WenWeiCheng/S16011-CCD/README.md

## FPGA 硬件平台

### CCD 模块

只管 CCD 的移位时序产生、数据缓存、数据发送，曝光时间由其它控制（比如计时器）。

时序逻辑：接收一个曝光结束信息，然后开始对像素进行移位读出。同时控制 ADC 对读出的模拟信号进行采样，解析输出数据，去掉bevel像素，保留暗像素和感光像素信号，数据存在 ram 中。

输入接口：

- 复位：同时清除缓存帧

- 曝光信号：下降沿开始电荷读出、模数转换、数据解析和缓存
- 图像高度 (16bit)：
- 图像宽度 (16bit)：
- 斜边像素 (16bit)：上下左右的数量
- 空白像素 (4bit)：左右数目
- 读出模式 (2bit)：area scan, line binning
- 垂直合并 (16bit)：垂直合并行数
- vertical-binning-offset (16bit)：垂直合并偏移
- 读出帧：下降沿启动一帧数据的读出

输出接口：

- USB 控制器 FIFO 接口
- 缓存帧数目
- CCD读出状态：空闲/忙
- 缓存读出状态：空闲/忙

存储帧长度、帧数等信息。接收帧发送指令，将一帧数据通过 FIFO 接口把数据发给 USB 控制器的 FIFO

### FPGA 框图

集成 CCD 模块、SPI 控制器、IIC 控制器、GPIO 模块、串口、计时器、MicroBlaze 软核。

## FPGA 软件

### 总线驱动
- GPIO 驱动：触发，启停信号

- SPI 驱动：ADC, DAC 寄存器配置和简单数据读取

- IIC 驱动：命令收发

- UART 驱动：调试

- Timer 驱动

通过uart、ila调试。
UART 驱动：回环，直接在主机上看结果
命令解析结果回显，mock 数据发送

总线驱动调试：uart触发调试，必要时用 ila 抓波形
SPI 驱动：uart触发，用 ILA 抓取波形
GPIO 驱动：uart触发，用 LED 输出状态
IIC 驱动：uart触发，用 ILA 抓取波形

### 设备驱动

都有 mock 模式，返回 mock 数据
TEC 驱动：启停，电压电流监控，功率设置
CCD 驱动：adc配置，曝光时间控制，开始/结束控制，读取ccd状态（曝光/读出/空闲），读取数据缓存状态，读取数据缓存，清空数据缓存，设置触发

设备驱动调试：设备模式，需要连接驱动板，真实数据回传，必要时配合ila查看实际波形
TEC 驱动：启停、电流、电压监控、功率设置
CCD 驱动：ADC 配置+数据读取和串口发送，主机用 python 接收和显示

### 主控

实现主机的命令解析和执行，命令可以来自iic，也可以来自 uart。发送数据可以通过USB，也可以通过uart。

uart 主控调试：无设备模式，不需要连接驱动板

## USB 控制器软件

命令、数据转发

## 主机的相机驱动和API封装

命令发送
数据获取

1. 测试下位机的命令循环
2. 底层驱动调试：设置一个 mock 模式，调用接口、收到伪数据
3. API 封装调试：在上位机中直接操作
