WenWeiCheng/S16011-CCD/00-docs/verilog-design/.assets/ccd-state-machine.png

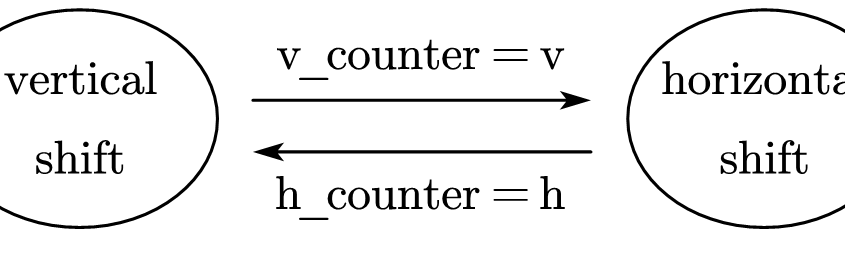
00-docs/verilog-design/.assets/ccd-state-machine.png
