WenWeiCheng/S16011-CCD/00-docs/verilog-design/.assets/ccd-write-fifo-sm.png

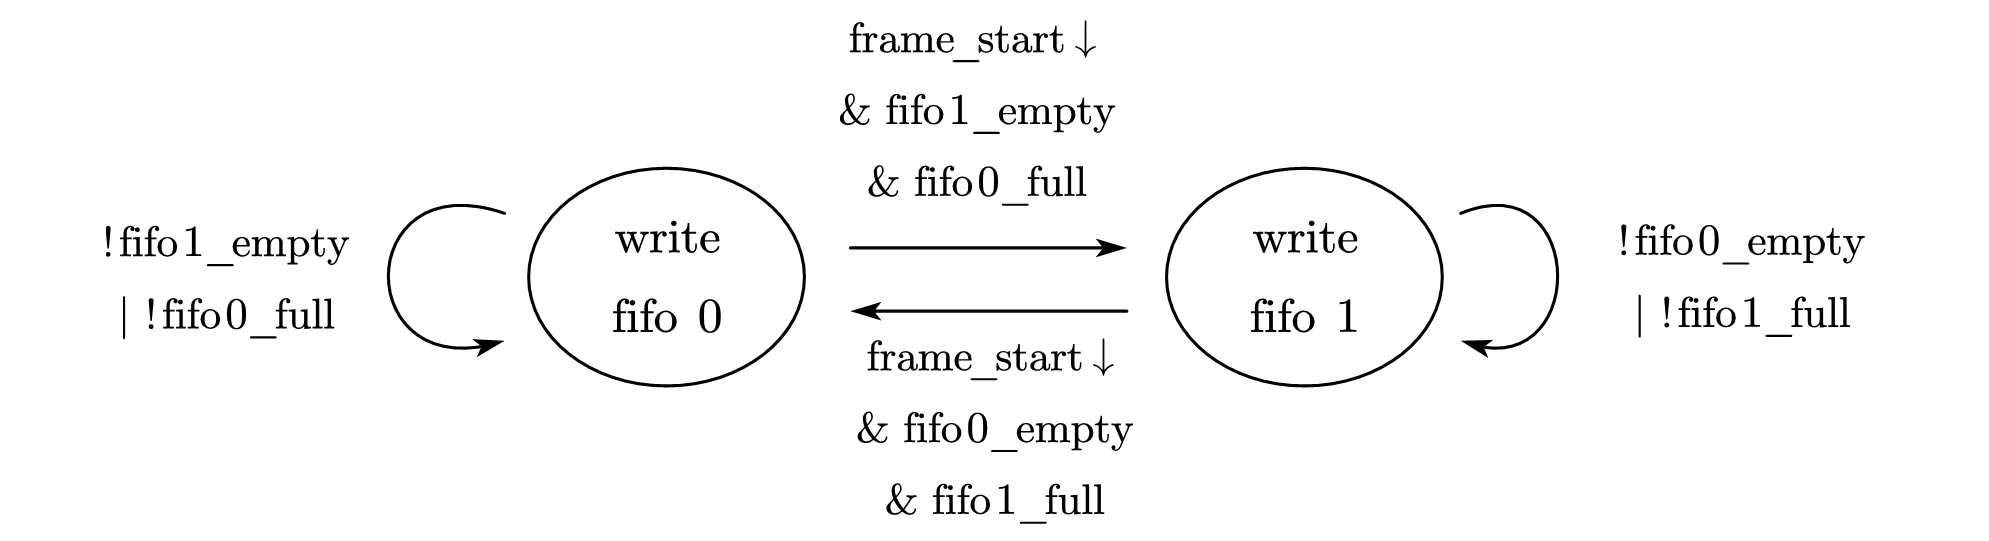
00-docs/verilog-design/.assets/ccd-write-fifo-sm.png
