WenWeiCheng/S16011-CCD/00-docs/verilog-design/statemachine/ccd-frame-buf-ddr-arch.png

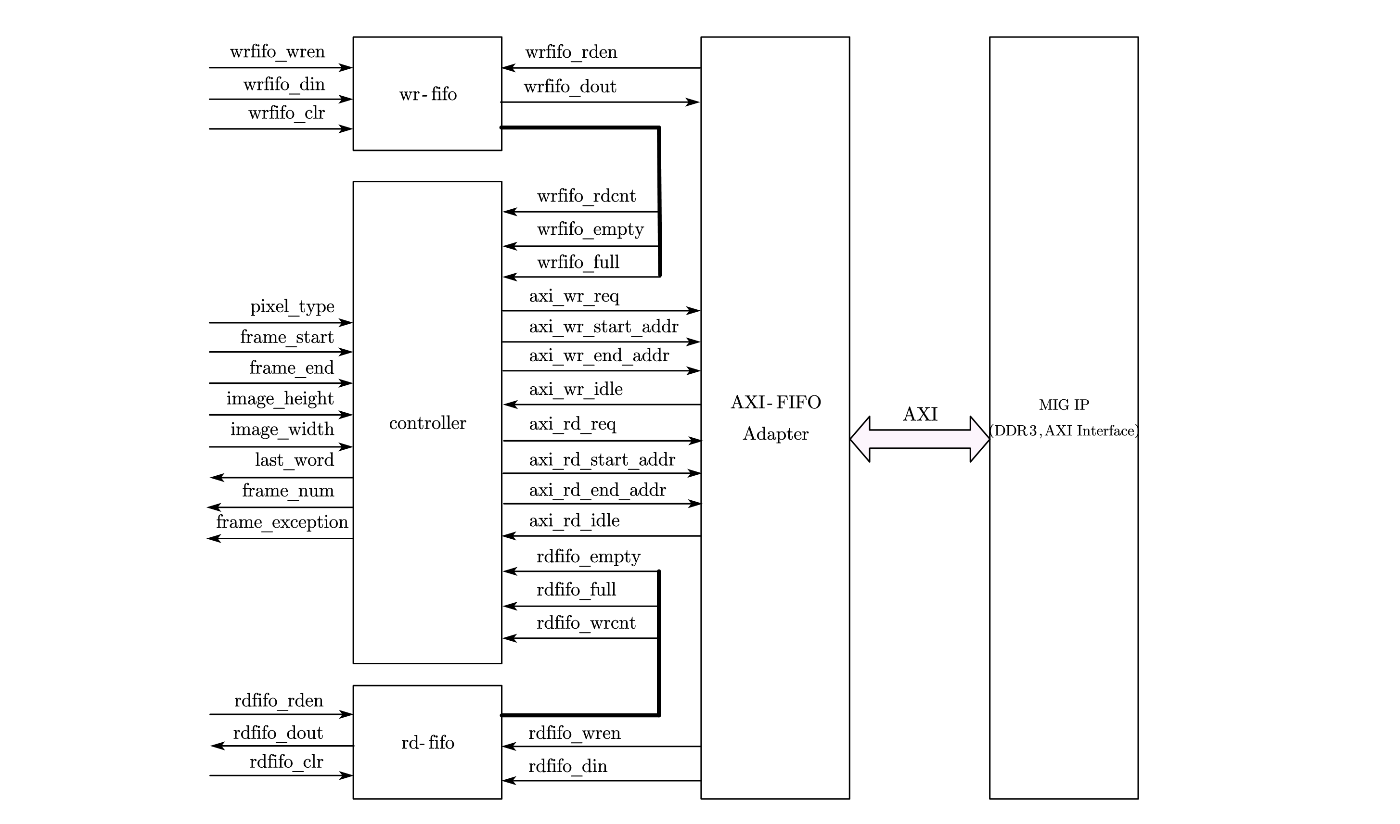
00-docs/verilog-design/statemachine/ccd-frame-buf-ddr-arch.png
