WenWeiCheng/S16011-CCD/00-docs/verilog-design/statemachine/ccd-memory-sm.png

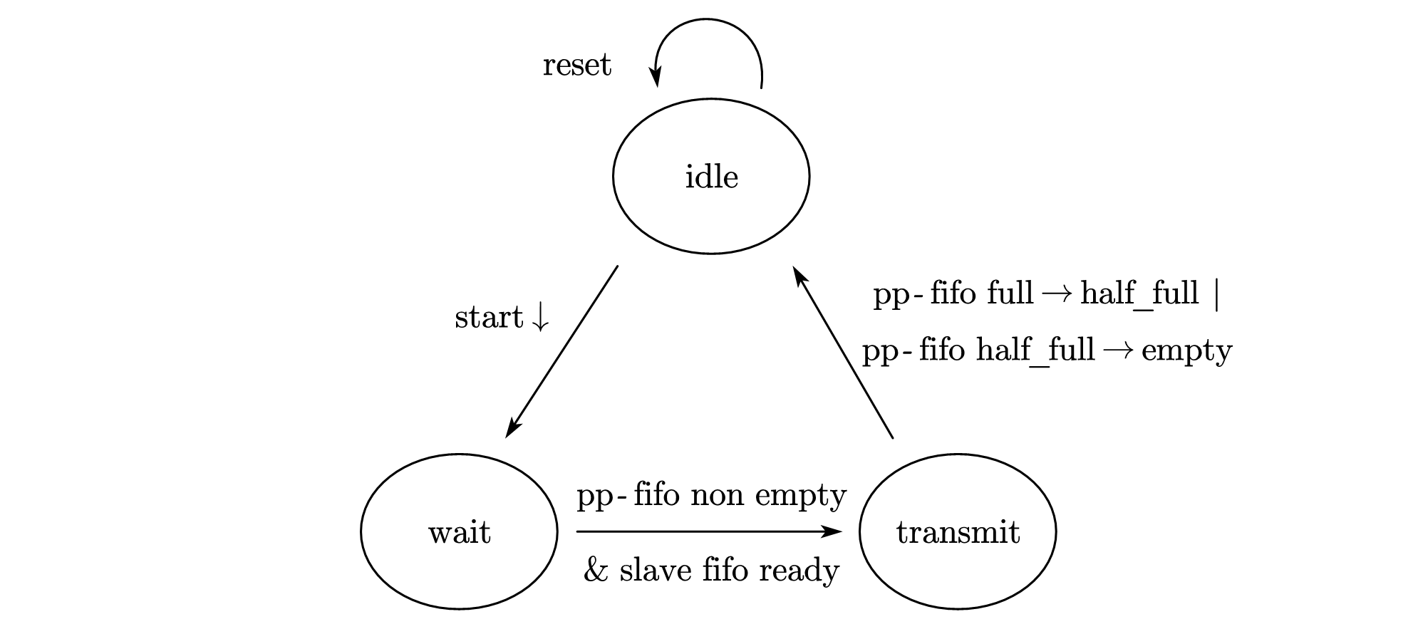
00-docs/verilog-design/statemachine/ccd-memory-sm.png
