WenWeiCheng/S16011-CCD/01-pcb/BOM.xlsx

Sheet: Driver
型号 | 类型 | 描述 | 零售单价 |  |  |  |  | 销售状态
 |  |  | DigiKey | Mouser | 立创商城 | 淘宝 | 最低价
AD4088 | ADC | 14-Bit, 10 MSPS, Low Noise, Low Power SAR ADC | ¥268.00 |  |  |  | ¥268.00 | New

Sheet: Controller
型号 | 类型 | 描述 | 零售单价 |  |  |  |  | 销售状态
 |  |  | DigiKey | Mouser | 立创商城 | 淘宝 | 最低价
CY7C68013A-56PVXC | USB 收发器 | EZ-USB® FX2LP TM USB 微控制器高速 USB 外设控制器 |  |  | ¥107.74 | ¥20.00 | ¥20.00 | EOL
