WenWeiCheng/S16011-CCD/01-pcb/old-driver/CCD驱动板电路原理图2025_03_28_dac8311_ads1118.pdf

# FPC1HC⁻FPC⁻⁰³⁻⁰⁹⁻³¹RLTAG

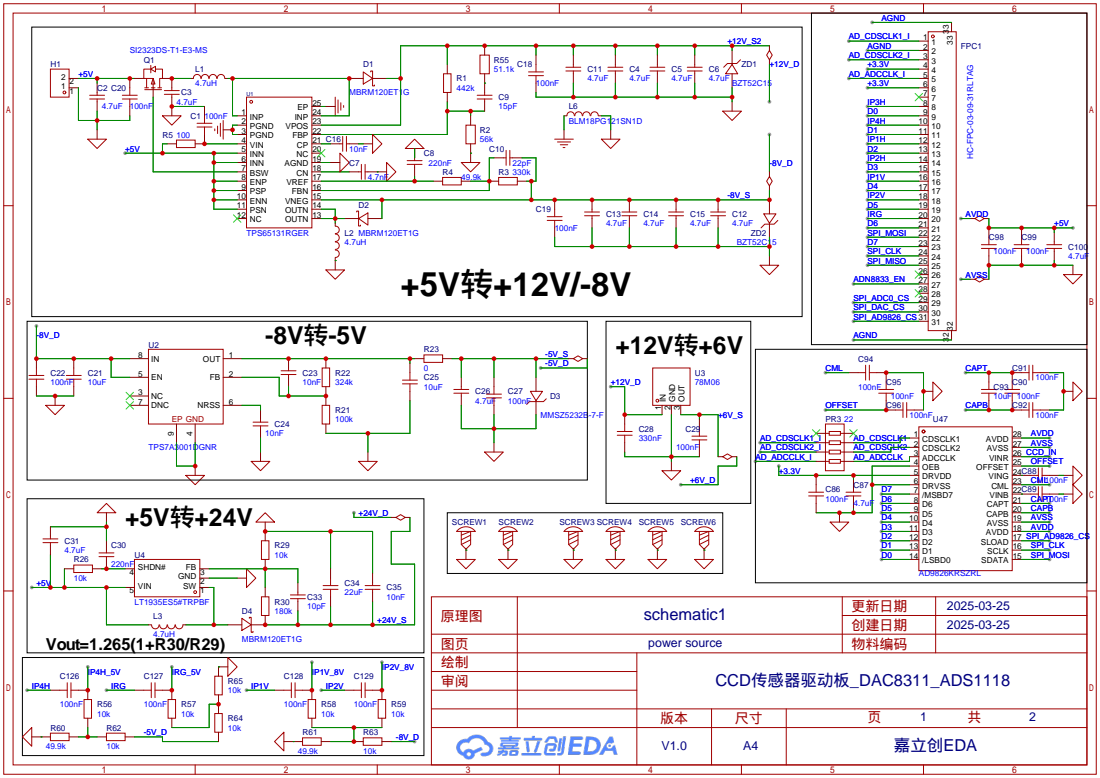
[picture p20: page 1]

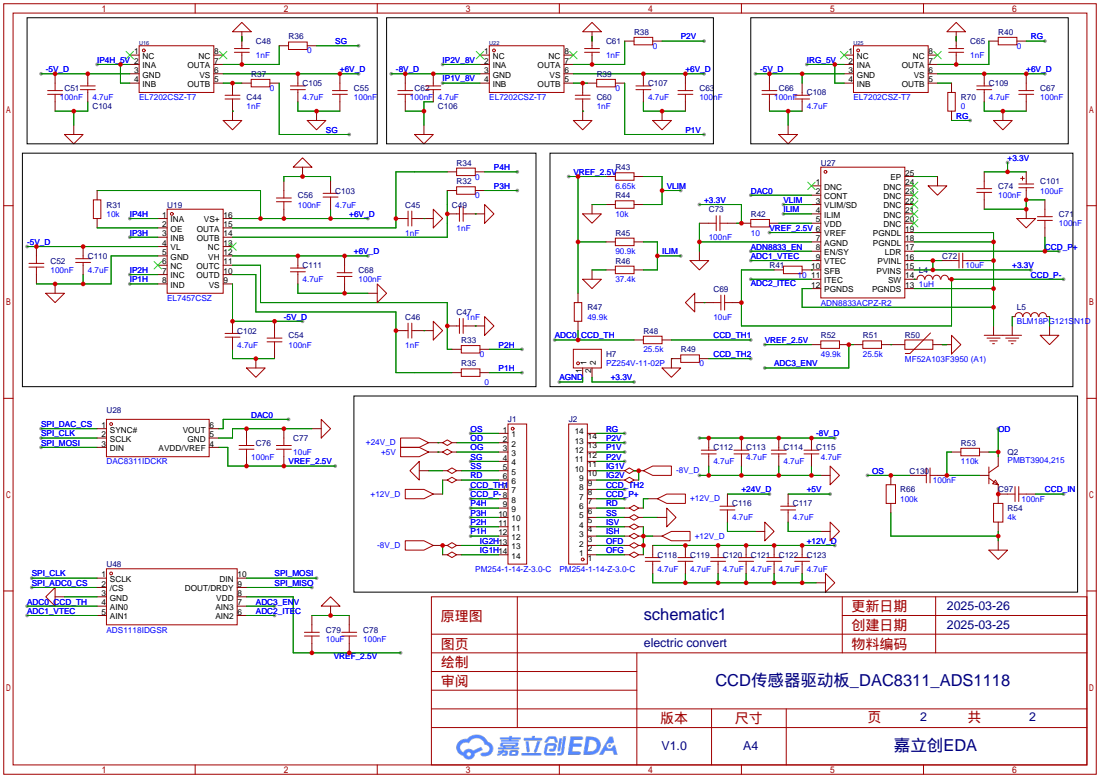
[picture p21: page 2]

OUTD 10 OUTC 11 VH 12 NC 13 OUTB 14 OUTA 15 VS+ 16
