WenWeiCheng/S16011-CCD/(list of files, drawings)

Other design files:
01-pcb/old-driver/CCD传感器驱动板_DAC8311_ADS1118.eprj
