WenWeiCheng/S16011-CCD/02-fpga/ccd_controller_software/ccd_controller_app/src/main.c

/******************************************************************************
* @file main.c
*
* CCD controller application entry: assembles the app logic layer.
*  - UART line -> Protocol (command dispatch table / parameter table / ACQ)
*  - Monitor telemetry sampling loop (ads1118 four channels: NTC x2 / TEC voltage / TEC current)
*  - Heartbeat -> key debounce; LED0 heartbeat blink
*
* @note <pre>
* MODIFICATION HISTORY:
*
 * Ver   Who  Date     Changes
 * ----- ---- -------- -----------------------------------------------
 * 1.0   wwc  26/08/03 Rewrite: wire app logic layer (UART protocol)
 * 1.0   wwc  26/08/02 First release (driver smoke test)
 * 1.1   wwc  26/08/07 主循环加 Ccd_Tick (live/burst 连续采集推进)
 * 1.2   wwc  26/08/07 移除 Ccd_Tick (采集环改由 FRAME_WRITTEN 中断驱动)
 * </pre>
******************************************************************************/
#include "devices/led.h"
#include "hal/board_hal.h"
#include "include/board_config.h"
#include "logic/protocol.h"
#include "logic/monitor.h"
#include "logic/tec_ctrl.h"
#include "xil_printf.h"
#include "xil_types.h"

/*****************************************************************************/
/**
* @brief  Heartbeat periodic task: key debounce FSM (must tick at 1ms).
******************************************************************************/
static void App_HeartbeatTick(void *ref)
{
    (void)ref;
    Key_Tick(&gKey, 1U);
}

/*****************************************************************************/
/**
* @brief  Main function.
******************************************************************************/
int main(void)
{
    u32 ledTick = 0U;

    if (BoardHal_Init() != XST_SUCCESS) {
        xil_printf("BoardHal_Init FAILED\r\n");
        return -1;
    }

    /* Assemble the app logic layer */
    Uart_RegisterLineHandler(&gUartDrv, Protocol_OnLine, NULL);
    Uart_RegisterErrorHandler(&gUartDrv, Protocol_OnError, NULL);
    Heartbeat_RegisterHandler(&gHeartbeat, App_HeartbeatTick, NULL);

    Monitor_Init(&gMonitor, &gAds1118, &gHeartbeat);
    TecCtrl_Init(&gTecCtrl, &gDac8311, &gAdn8833, &gMonitor);
    Protocol_Init();

    while (1) {
        u32 tick = Heartbeat_GetTick(&gHeartbeat);

        Monitor_Tick(&gMonitor);
        TecCtrl_Tick(&gTecCtrl);
        Protocol_ProcessPending();

        /* LED0 heartbeat blink (500ms) */
        if (tick - ledTick >= 500U) {
            ledTick = tick;
            Led_Toggle(&gLed, 0);
        }
    }
}
