WenWeiCheng/S16011-CCD/02-fpga/ccd_controller_hardware/constraint/port.xdc

set_property PACKAGE_PIN Y18 [get_ports clk_50MHz]
set_property IOSTANDARD LVCMOS33 [get_ports clk_50MHz]
set_property IOSTANDARD LVCMOS33 [get_ports {i_adc_data[0]}]
set_property IOSTANDARD LVCMOS33 [get_ports {i_adc_data[1]}]
set_property IOSTANDARD LVCMOS33 [get_ports {i_adc_data[2]}]
set_property IOSTANDARD LVCMOS33 [get_ports {i_adc_data[3]}]
set_property IOSTANDARD LVCMOS33 [get_ports {i_adc_data[4]}]
set_property PACKAGE_PIN F16 [get_ports {i_adc_data[7]}]
set_property PACKAGE_PIN E16 [get_ports {i_adc_data[6]}]
set_property PACKAGE_PIN W1 [get_ports {DDR3_addr[5]}]
set_property PACKAGE_PIN AB2 [get_ports {DDR3_addr[4]}]
set_property PACKAGE_PIN U1 [get_ports {DDR3_addr[3]}]
set_property PACKAGE_PIN C13 [get_ports {i_adc_data[4]}]
set_property PACKAGE_PIN A13 [get_ports {i_adc_data[5]}]
set_property PACKAGE_PIN C14 [get_ports {i_adc_data[3]}]
set_property PACKAGE_PIN B15 [get_ports {i_adc_data[2]}]
set_property PACKAGE_PIN A15 [get_ports {i_adc_data[1]}]
set_property PACKAGE_PIN B17 [get_ports {i_adc_data[0]}]
set_property IOSTANDARD LVCMOS33 [get_ports {i_adc_data[7]}]
set_property IOSTANDARD LVCMOS33 [get_ports {i_adc_data[6]}]
set_property IOSTANDARD LVCMOS33 [get_ports {i_adc_data[5]}]
set_property PACKAGE_PIN N20 [get_ports i_slave_fifo_empty_n]
set_property IOSTANDARD LVCMOS33 [get_ports i_slave_fifo_empty_n]
set_property PACKAGE_PIN M20 [get_ports i_slave_fifo_full_n]
set_property IOSTANDARD LVCMOS33 [get_ports i_slave_fifo_full_n]

set_property PACKAGE_PIN G13 [get_ports iic_scl_io]
set_property PACKAGE_PIN H13 [get_ports iic_sda_io]
set_property IOSTANDARD LVCMOS33 [get_ports iic_sda_io]
set_property IOSTANDARD LVCMOS33 [get_ports iic_scl_io]
set_property PACKAGE_PIN D17 [get_ports o_adcclk]
set_property IOSTANDARD LVCMOS33 [get_ports o_adcclk]
set_property PACKAGE_PIN F18 [get_ports o_cdsclk1]
set_property IOSTANDARD LVCMOS33 [get_ports o_cdsclk1]
set_property PACKAGE_PIN C17 [get_ports o_cdsclk2]
set_property IOSTANDARD LVCMOS33 [get_ports o_cdsclk2]
set_property PACKAGE_PIN B16 [get_ports o_p1h]
set_property IOSTANDARD LVCMOS33 [get_ports o_p1h]
set_property PACKAGE_PIN B13 [get_ports o_p1v]
set_property IOSTANDARD LVCMOS33 [get_ports o_p1v]
set_property PACKAGE_PIN C15 [get_ports o_p2h]
set_property IOSTANDARD LVCMOS33 [get_ports o_p2h]
set_property PACKAGE_PIN A14 [get_ports o_p2v_tg]
set_property IOSTANDARD LVCMOS33 [get_ports o_p2v_tg]
set_property PACKAGE_PIN B18 [get_ports o_p3h]
set_property IOSTANDARD LVCMOS33 [get_ports o_p3h]
set_property PACKAGE_PIN A16 [get_ports o_p4h_sg]
set_property IOSTANDARD LVCMOS33 [get_ports o_p4h_sg]
set_property PACKAGE_PIN D16 [get_ports o_rg]
set_property IOSTANDARD LVCMOS33 [get_ports o_rg]
set_property PACKAGE_PIN H18 [get_ports o_slave_fifo_clk]
set_property IOSTANDARD LVCMOS33 [get_ports o_slave_fifo_clk]
set_property PACKAGE_PIN N22 [get_ports {o_slave_fifo_data[0]}]
set_property IOSTANDARD LVCMOS33 [get_ports {o_slave_fifo_data[0]}]
set_property PACKAGE_PIN M22 [get_ports {o_slave_fifo_data[1]}]
set_property IOSTANDARD LVCMOS33 [get_ports {o_slave_fifo_data[1]}]
set_property PACKAGE_PIN K17 [get_ports {o_slave_fifo_data[2]}]
set_property IOSTANDARD LVCMOS33 [get_ports {o_slave_fifo_data[2]}]
set_property PACKAGE_PIN J17 [get_ports {o_slave_fifo_data[3]}]
set_property IOSTANDARD LVCMOS33 [get_ports {o_slave_fifo_data[3]}]
set_property PACKAGE_PIN K18 [get_ports {o_slave_fifo_data[4]}]
set_property IOSTANDARD LVCMOS33 [get_ports {o_slave_fifo_data[4]}]
set_property PACKAGE_PIN K19 [get_ports {o_slave_fifo_data[5]}]
set_property IOSTANDARD LVCMOS33 [get_ports {o_slave_fifo_data[5]}]
set_property PACKAGE_PIN L19 [get_ports {o_slave_fifo_data[6]}]
set_property IOSTANDARD LVCMOS33 [get_ports {o_slave_fifo_data[6]}]
set_property PACKAGE_PIN L20 [get_ports {o_slave_fifo_data[7]}]
set_property IOSTANDARD LVCMOS33 [get_ports {o_slave_fifo_data[7]}]
set_property PACKAGE_PIN L15 [get_ports {o_slave_fifo_data[8]}]
set_property IOSTANDARD LVCMOS33 [get_ports {o_slave_fifo_data[8]}]
set_property PACKAGE_PIN M13 [get_ports {o_slave_fifo_data[9]}]
set_property IOSTANDARD LVCMOS33 [get_ports {o_slave_fifo_data[9]}]
set_property PACKAGE_PIN L13 [get_ports {o_slave_fifo_data[10]}]
set_property IOSTANDARD LVCMOS33 [get_ports {o_slave_fifo_data[10]}]
set_property PACKAGE_PIN K13 [get_ports {o_slave_fifo_data[11]}]
set_property IOSTANDARD LVCMOS33 [get_ports {o_slave_fifo_data[11]}]
set_property PACKAGE_PIN K14 [get_ports {o_slave_fifo_data[12]}]
set_property IOSTANDARD LVCMOS33 [get_ports {o_slave_fifo_data[12]}]
set_property PACKAGE_PIN J15 [get_ports {o_slave_fifo_data[13]}]
set_property IOSTANDARD LVCMOS33 [get_ports {o_slave_fifo_data[13]}]
set_property PACKAGE_PIN H15 [get_ports {o_slave_fifo_data[14]}]
set_property IOSTANDARD LVCMOS33 [get_ports {o_slave_fifo_data[14]}]
set_property PACKAGE_PIN G15 [get_ports {o_slave_fifo_data[15]}]
set_property IOSTANDARD LVCMOS33 [get_ports {o_slave_fifo_data[15]}]

set_property PACKAGE_PIN V17 [get_ports reset]
set_property PACKAGE_PIN E17 [get_ports spi_io0_io]
set_property PACKAGE_PIN D14 [get_ports spi_io1_io]
set_property PACKAGE_PIN D15 [get_ports spi_sck_io]
set_property PACKAGE_PIN F13 [get_ports {spi_ss_io[0]}]
set_property PACKAGE_PIN F14 [get_ports {spi_ss_io[1]}]
set_property PACKAGE_PIN E13 [get_ports {spi_ss_io[2]}]
set_property PACKAGE_PIN N13 [get_ports uart_rxd]
set_property PACKAGE_PIN N14 [get_ports uart_txd]
set_property IOSTANDARD LVCMOS33 [get_ports uart_txd]
set_property IOSTANDARD LVCMOS33 [get_ports uart_rxd]
set_property IOSTANDARD LVCMOS33 [get_ports {spi_ss_io[2]}]
set_property IOSTANDARD LVCMOS33 [get_ports {spi_ss_io[1]}]
set_property IOSTANDARD LVCMOS33 [get_ports {spi_ss_io[0]}]
set_property IOSTANDARD LVCMOS33 [get_ports spi_sck_io]
set_property IOSTANDARD LVCMOS33 [get_ports spi_io1_io]
set_property IOSTANDARD LVCMOS33 [get_ports spi_io0_io]
set_property IOSTANDARD LVCMOS33 [get_ports reset]



set_property PACKAGE_PIN G18 [get_ports {gpio_fx2_fifo_tri_io[1]}]
set_property IOSTANDARD LVCMOS33 [get_ports {gpio_fx2_fifo_tri_io[1]}]
set_property PACKAGE_PIN L18 [get_ports {gpio_fx2_fifo_tri_io[0]}]
set_property IOSTANDARD LVCMOS33 [get_ports {gpio_fx2_fifo_tri_io[0]}]
set_property PACKAGE_PIN K16 [get_ports {gpio_fx2_fifo_tri_io[2]}]
set_property IOSTANDARD LVCMOS33 [get_ports {gpio_fx2_fifo_tri_io[2]}]
set_property PACKAGE_PIN M15 [get_ports {gpio_fx2_fifo_tri_io[3]}]
set_property IOSTANDARD LVCMOS33 [get_ports {gpio_fx2_fifo_tri_io[3]}]
set_property PACKAGE_PIN N19 [get_ports {gpio_fx2_fifo_tri_io[4]}]
set_property IOSTANDARD LVCMOS33 [get_ports {gpio_fx2_fifo_tri_io[4]}]
set_property IOSTANDARD LVCMOS33 [get_ports {gpio_general_tri_io[0]}]
set_property PACKAGE_PIN E14 [get_ports {gpio_general_tri_io[0]}]

set_property PACKAGE_PIN P20 [get_ports {gpio_key_tri_i[0]}]
set_property PACKAGE_PIN AB18 [get_ports {gpio_key_tri_i[1]}]
set_property IOSTANDARD LVCMOS33 [get_ports {gpio_key_tri_i[1]}]
set_property IOSTANDARD LVCMOS33 [get_ports {gpio_key_tri_i[0]}]
set_property PACKAGE_PIN Y19 [get_ports {gpio_led_tri_o[0]}]
set_property PACKAGE_PIN AA18 [get_ports {gpio_led_tri_o[1]}]
set_property IOSTANDARD LVCMOS33 [get_ports {gpio_led_tri_o[0]}]
set_property IOSTANDARD LVCMOS33 [get_ports {gpio_led_tri_o[1]}]
set_property PACKAGE_PIN M16 [get_ports o_slave_fifo_data_last_n]
set_property IOSTANDARD LVCMOS33 [get_ports o_slave_fifo_data_last_n]
set_property PACKAGE_PIN H17 [get_ports o_slave_fifo_data_wr_en_n]
set_property IOSTANDARD LVCMOS33 [get_ports o_slave_fifo_data_wr_en_n]
set_property PACKAGE_PIN M17 [get_ports {gpio_key_tri_i[2]}]
set_property PACKAGE_PIN R19 [get_ports {gpio_key_tri_i[3]}]
set_property PACKAGE_PIN J16 [get_ports {gpio_led_tri_o[2]}]
set_property PACKAGE_PIN J20 [get_ports {gpio_led_tri_o[3]}]
set_property IOSTANDARD LVCMOS33 [get_ports {gpio_led_tri_o[3]}]
set_property IOSTANDARD LVCMOS33 [get_ports {gpio_led_tri_o[2]}]
set_property IOSTANDARD LVCMOS33 [get_ports {gpio_key_tri_i[3]}]
set_property IOSTANDARD LVCMOS33 [get_ports {gpio_key_tri_i[2]}]
set_property PACKAGE_PIN J21 [get_ports {gpio_general_tri_io[1]}]
set_property PACKAGE_PIN K21 [get_ports {gpio_general_tri_io[2]}]
set_property PACKAGE_PIN K22 [get_ports {gpio_general_tri_io[3]}]
set_property IOSTANDARD LVCMOS33 [get_ports {gpio_general_tri_io[1]}]
set_property IOSTANDARD LVCMOS33 [get_ports {gpio_general_tri_io[2]}]
set_property IOSTANDARD LVCMOS33 [get_ports {gpio_general_tri_io[3]}]


set_property PULLUP true [get_ports i_slave_fifo_empty_n]
set_property PULLUP true [get_ports i_slave_fifo_full_n]
