WenWeiCheng/S16011-CCD/02-fpga/ccd_controller_software/ccd_controller_app/src/include/board_config.h

/******************************************************************************
* @file board_config.h
*
* Board-level configuration: SPI chip selects, GPIO bit mappings, DAC/ADC references, NTC parameters, etc.
*
* This file contains only "board facts", no Xilinx names (XPAR_*), to ease porting to other platforms.
* The concrete Xilinx device / interrupt vector mapping is in hal/board_hal.c.
*
 * @note <pre>
 * MODIFICATION HISTORY:
 *
 * Ver   Who  Date     Changes
 * ----- ---- -------- -----------------------------------------------
 * 1.0   wwc  26/08/02 First release
 * 1.1   wwc  26/08/07 新增 CCD_MAX_FRAMES (帧缓存容量, 与 BD MAX_FRAMES 同步)
 * </pre>
******************************************************************************/
#ifndef BOARD_CONFIG_H
#define BOARD_CONFIG_H

#include "xil_types.h"

#ifdef __cplusplus
extern "C" {
#endif

/* ============================================================================
 * SPI chip select assignment (AXI Quad SPI, 3 chip selects, 16-bit frames)
 * ==========================================================================*/
#define SPI_CS_AD9826            0U   /* CCD ADC */
#define SPI_CS_DAC8311           1U   /* TEC output voltage DAC */
#define SPI_CS_ADS1118           2U   /* thermistor / TEC voltage-current ADC */

#define SPI_TRANSFER_BITS        16U  /* all three chips use 16-bit frames */

/* ============================================================================
 * GPIO bit mapping
 * ==========================================================================*/
/* Gpio_fx2fifo (XPAR_GPIO_0) */
#define FX2_GPIO_SLOE_N_BIT      0U   /* output */
#define FX2_GPIO_SLRD_N_BIT      1U   /* output */
#define FX2_GPIO_FIFO_ADDR0_BIT  2U   /* output */
#define FX2_GPIO_FIFO_ADDR1_BIT  3U   /* output */
#define FX2_GPIO_PA0_BIT         4U   /* input, FX2 sync: 1=config done */

#define FX2_GPIO_OUT_MASK        ((1U<<FX2_GPIO_SLOE_N_BIT) | \
                                  (1U<<FX2_GPIO_SLRD_N_BIT) | \
                                  (1U<<FX2_GPIO_FIFO_ADDR0_BIT) | \
                                  (1U<<FX2_GPIO_FIFO_ADDR1_BIT))
#define FX2_GPIO_IN_MASK         (1U<<FX2_GPIO_PA0_BIT)

/* Gpio_general (XPAR_GPIO_1) */
#define ADN8833_EN_BIT           0U   /* output, TEC power enable */
#define ADN8833_EN_MASK          (1U<<ADN8833_EN_BIT)

/* Gpio_key (XPAR_GPIO_2, with interrupts) */
#define KEY0_BIT                 0U   /* input */
#define KEY1_BIT                 1U   /* input */
#define KEY_IN_MASK              ((1U<<KEY0_BIT) | (1U<<KEY1_BIT))

/* Gpio_led (XPAR_GPIO_3) */
#define LED0_BIT                 0U   /* output */
#define LED1_BIT                 1U   /* output */
#define LED_OUT_MASK             ((1U<<LED0_BIT) | (1U<<LED1_BIT))

/*
 * LED polarity: 1=active low (most boards), 0=active high.
 * If the actual board is reversed, change it here; the driver inverts per this macro.
 */
#define LED_ACTIVE_LOW           0U

/* Key active-level mask: bits set to 1 are active low (pressed=0), bits set to 0 are active high. */
#define KEY_ACTIVE_LOW_MASK      (KEY_IN_MASK)

/* ============================================================================
 * System clock (used for timer period conversion)
 * ==========================================================================*/
#define BOARD_CLK_FREQ_HZ        100000000UL   /* MicroBlaze system clock 100MHz */

/* ============================================================================
 * dac8311
 * ==========================================================================*/
#define DAC8311_VREF_V           2.5f          /* reference voltage 2.5V, 14-bit */

/* ============================================================================
 * ads1118
 * ==========================================================================*/
#define ADS1118_FS_VOLT          4.096f        /* PGA=000b full scale +/-4.096V */
#define ADS1118_SPS              860U          /* DR=110b data rate */

/* ============================================================================
 * NTC thermistor (per channel: sensor AIN0 / environment AIN3)
 *
 * Both channels use the same divider topology (confirmed):
 *   Vref - R1 - (tap) - R2 - Rntc - GND
 * The ADC measures the tap voltage (R1/R2 node to GND):
 *   V = Vref * (R2 + Rntc) / (R1 + R2 + Rntc)
 * Placeholder constants below are used by tools/gen_ntc_table.py to generate the
 * code -> temperature lookup tables in src/logic/ntc_tables.h (GENERATED FILE,
 * do not edit by hand).
 *
 * TODO(pending confirmation): currently placeholders (R1=R2=R25=10k, B=3435,
 * Vref=2.5V, identical for both channels). Replace after obtaining the actual
 * NTC specs / divider resistors from the board BOM, then re-run the generator.
 * ==========================================================================*/
#define NTC_SENSOR_R1_OHM        10000         /* top divider resistor */
#define NTC_SENSOR_R2_OHM        10000         /* divider resistor in series with the NTC */
#define NTC_SENSOR_R25_OHM       10000         /* nominal resistance at 25C */
#define NTC_SENSOR_BETA          3435          /* B value (25/85) */
#define NTC_SENSOR_DIV_VREF_V    2.5f          /* divider reference voltage */

#define NTC_ENV_R1_OHM           10000         /* top divider resistor */
#define NTC_ENV_R2_OHM           10000         /* divider resistor in series with the NTC */
#define NTC_ENV_R25_OHM          10000         /* nominal resistance at 25C */
#define NTC_ENV_BETA             3435          /* B value (25/85) */
#define NTC_ENV_DIV_VREF_V       2.5f          /* divider reference voltage */

/* ============================================================================
 * S16011 sensor default geometry (image/bevel/blank, see 00-docs/verilog-design/ccd_driver.md)
 * ==========================================================================*/
#define CCD_IMG_WIDTH_DEFAULT    8U
#define CCD_IMG_HEIGHT_DEFAULT   1U
#define CCD_BEVEL_L_DEFAULT      1U
#define CCD_BEVEL_T_DEFAULT      1U
#define CCD_BEVEL_R_DEFAULT      1U
#define CCD_BEVEL_B_DEFAULT      1U
#define CCD_BLANK_L_DEFAULT      1U
#define CCD_BLANK_R_DEFAULT      1U

/* ============================================================================
 * CCD frame cache (DDR3 block ring)
 * 须与 BD 中 ccd_controller IP 的 MAX_FRAMES 参数保持一致。
 * ==========================================================================*/
#define CCD_MAX_FRAMES           2000U

/* ============================================================================
 * ADN8833 TEC control / monitor conversion (dac8311 Vcont, ads1118 AIN1/AIN2)
 *   Vtec = 5 * (1.25 - Vcont)    DAC output Vcont -> TEC output voltage
 *   Vtec = 4 * (Vvm - 1.25)      ADN8833 VVM monitor -> TEC output voltage
 *   Itec = 1.905 * (Vim - 1.25)  ADN8833 VIM monitor -> TEC output current
 * The three references share the same 1.25V mid-scale offset.
 * ==========================================================================*/
#define ADN8833_VCONT_REF_V      1.25f         /* Vcont/Vvm/Vim mid-scale reference */
#define ADN8833_VTEC_PER_VCONT    5.0f         /* Vtec per V below VCONT_REF (inverted) */
#define ADN8833_VTEC_PER_VMON     4.0f         /* Vtec per V above VCONT_REF */
#define ADN8833_ITEC_PER_IMON     1.905f       /* Atec per V above VCONT_REF */

/* ============================================================================
 * TEC temperature PID control (see logic/tec_ctrl.c)
 * PID output clamp range = +/- VDD = +/- 3.3V.
 * ==========================================================================*/
#define TEC_CTRL_VTEC_MIN_V      -3.3f         /* PID output clamp, -VDD */
#define TEC_CTRL_VTEC_MAX_V       3.3f         /* PID output clamp, +VDD */

#ifdef __cplusplus
}
#endif

#endif /* BOARD_CONFIG_H */
