WenWeiCheng/S16011-CCD/02-fpga/ccd_controller_software/ccd_controller_app/src/hal/ccd_controller.c

/******************************************************************************
* @file ccd_controller.c
*
* Driver implementation for the custom IP ccd_controller (AXI4-Lite).
*
* Register map is in 00-docs/verilog-design/ccd_controller_ip.md.
* This driver has no corresponding libsrc in the BSP, all hand-written; names do not
* start with X for easier cross-platform porting.
*
* @note <pre>
* MODIFICATION HISTORY:
*
 * Ver   Who  Date     Changes
 * ----- ---- -------- -----------------------------------------------
 * 1.0   wwc  26/08/02 First release
 * 1.1   wwc  26/08/03 Complete function doc comments (Xilinx style)
 * 1.2   wwc  26/08/07 GetFrameNum 改读 FRAME_NUM[0x1C] (32bit)
 * 1.3   wwc  26/08/07 IntrEnable 支持 FRAME_WRITTEN (INTR[10])
 * 1.4   wwc  26/08/08 新增 SoftReset: 写 CTRL[12]=1 触发总复位自清脉冲
 * </pre>
******************************************************************************/
#include "ccd_controller.h"
#include "xparameters.h"
#include "xil_assert.h"

/******************************************************************************
* Config lookup table
******************************************************************************/
/*
 * xparameters.h only has base address macros, no separate DeviceID / interrupt
 * vector aliases, so DeviceId is 0 and IntrVecId uses the raw INTC vector number
 * directly.
 */
static CcdController_Config CcdController_ConfigTable[] = {
    {
        .DeviceId   = 0,
        .BaseAddress = XPAR_CCD_CONTROLLER_V1_0_0_BASEADDR,
        .IntrVecId  = XPAR_MICROBLAZE_0_AXI_INTC_CCD_CONTROLLER_V1_0_0_INTR_INTR,
    }
};

#define CCD_CONTROLLER_NUM_CONFIGS \
    (sizeof(CcdController_ConfigTable) / sizeof(CcdController_ConfigTable[0]))

/*****************************************************************************/
/**
* @brief  Looks up the config by DeviceId.
*
* @param  DeviceId The ID to look up (always 0 on this board).
*
* @return Config pointer, or NULL if not found.
******************************************************************************/
CcdController_Config *CcdController_LookupConfig(u16 DeviceId)
{
    u32 i;
    for (i = 0; i < CCD_CONTROLLER_NUM_CONFIGS; i++) {
        if (CcdController_ConfigTable[i].DeviceId == DeviceId) {
            return &CcdController_ConfigTable[i];
        }
    }
    return NULL;
}

/*****************************************************************************/
/**
* @brief  Initializes the driver instance.
*
* Only writes BaseAddress/IsReady, does not preset image parameters (to avoid
* overwriting config already set by the caller).
*
* @param  p    Instance pointer.
* @param  cfg  Config returned by LookupConfig.
* @param  addr Valid address (usually cfg->BaseAddress).
*
* @return XST_SUCCESS / XST_DEVICE_NOT_FOUND / XST_FAILURE.
******************************************************************************/
int CcdController_CfgInitialize(CcdController *p, CcdController_Config *cfg,
                                u32 addr)
{
    Xil_AssertNonvoid(p != NULL);

    if (cfg == NULL) {
        return XST_DEVICE_NOT_FOUND;
    }

    p->Config = *cfg;
    p->BaseAddress = addr;
    p->IsReady = 0U;
    p->IsStarted = 0U;
    p->Handler = NULL;
    p->CallBackRef = NULL;

    /* Power-on reset: disable interrupts, clear the exposure bit */
    CcdController_WriteReg(p, CCDC_REG_INTR_EN, 0U);
    CcdController_WriteReg(p, CCDC_REG_INTR_STS, CCDC_INTR_ALL);

    p->IsReady = 1U;
    return XST_SUCCESS;
}

/*****************************************************************************/
/**
* @brief  Register read/write self-test.
*
* Verifies R/W registers with a "write-read back-restore" check; write-only
* registers (TRIGGER) are not involved.
*
* @param  p Instance pointer.
*
* @return XST_SUCCESS / XST_FAILURE.
******************************************************************************/
int CcdController_SelfTest(CcdController *p)
{
    u32 rw_regs[3] = { CCDC_REG_CTRL, CCDC_REG_IMG_SIZE, CCDC_REG_BEVEL_BLANK };
    u32 saved[3];
    u32 i;

    Xil_AssertNonvoid(p != NULL);

    if (!p->IsReady) {
        return XST_DEVICE_NOT_FOUND;
    }

    for (i = 0; i < 3; i++) {
        saved[i] = CcdController_ReadReg(p, rw_regs[i]);
    }

    /* Write a known pattern and read it back (avoiding reserved/read-only bits;
     * the CTRL test value excludes bit0=exposure so the self-test does not
     * accidentally trigger capture) */
    CcdController_WriteReg(p, CCDC_REG_IMG_SIZE, 0x12345678U);
    if (CcdController_ReadReg(p, CCDC_REG_IMG_SIZE) != 0x12345678U) {
        return XST_FAILURE;
    }

    CcdController_WriteReg(p, CCDC_REG_BEVEL_BLANK, 0x00FF1111U);
    if (CcdController_ReadReg(p, CCDC_REG_BEVEL_BLANK) != 0x00FF1111U) {
        return XST_FAILURE;
    }

    CcdController_WriteReg(p, CCDC_REG_CTRL, 0x0000FFF0U);
    if (CcdController_ReadReg(p, CCDC_REG_CTRL) != 0x0000FFF0U) {
        return XST_FAILURE;
    }

    /* Restore the original values */
    for (i = 0; i < 3; i++) {
        CcdController_WriteReg(p, rw_regs[i], saved[i]);
    }

    return XST_SUCCESS;
}

/*****************************************************************************/
/**
* @brief  Sets the image size (writes IMG_SIZE).
*
* @param  p  CcdController instance.
* @param  w  Image width in pixels (1..2048, IMG_SIZE[15:0]).
* @param  h  Image height in pixels (1..64, IMG_SIZE[31:16]).
******************************************************************************/
void CcdController_SetImageSize(CcdController *p, u16 w, u16 h)
{
    CcdController_WriteReg(p, CCDC_REG_IMG_SIZE,
                           ((u32)h << 16) | (u32)w);
}

/*****************************************************************************/
/**
* @brief  Sets the bevel/blank parameters (writes BEVEL_BLANK).
*
* Each 4-bit field is masked and packed into its register slot.
*
* @param  p   CcdController instance.
* @param  bb  Bevel/blank values; NULL is ignored (returns without writing).
******************************************************************************/
void CcdController_SetBevelBlank(CcdController *p,
                                 const CcdController_BevelBlank *bb)
{
    u32 val = 0U;
    if (bb == NULL) {
        return;
    }
    val |= ((u32)(bb->BevelLeft   & 0xFU) << 0);
    val |= ((u32)(bb->BevelTop    & 0xFU) << 4);
    val |= ((u32)(bb->BevelRight  & 0xFU) << 8);
    val |= ((u32)(bb->BevelBottom & 0xFU) << 12);
    val |= ((u32)(bb->BlankLeft   & 0xFU) << 16);
    val |= ((u32)(bb->BlankRight  & 0xFU) << 20);
    CcdController_WriteReg(p, CCDC_REG_BEVEL_BLANK, val);
}

/*****************************************************************************/
/**
* @brief  Sets the CDSCLK fine-tune delay (writes CTRL[11:5]).
*
* Read-modify-write keeps the other CTRL bits unchanged.
*
* @param  p      CcdController instance.
* @param  delay  Fine delay taps, 0..127 (only [6:0] is used).
******************************************************************************/
void CcdController_SetCdsclkDelay(CcdController *p, u8 delay)
{
    u32 ctrl = CcdController_ReadReg(p, CCDC_REG_CTRL);
    ctrl &= ~CCDC_CTRL_CDSCLK_DELAY_MASK;
    ctrl |= ((u32)(delay & 0x7FU) << 5);
    CcdController_WriteReg(p, CCDC_REG_CTRL, ctrl);
}

/*****************************************************************************/
/**
* @brief  Sets the readout mode (writes CTRL[4:3]).
*
* Read-modify-write keeps the other CTRL bits unchanged.
*
* @param  p     CcdController instance.
* @param  mode  CCDC_READ_MODE_LINE_BINNING (0) or CCDC_READ_MODE_IMAGE (1).
******************************************************************************/
void CcdController_SetReadMode(CcdController *p, u8 mode)
{
    u32 ctrl = CcdController_ReadReg(p, CCDC_REG_CTRL);
    ctrl &= ~CCDC_CTRL_READ_MODE_MASK;
    ctrl |= ((u32)(mode & 0x3U) << 3);
    CcdController_WriteReg(p, CCDC_REG_CTRL, ctrl);
}

/*****************************************************************************/
/**
* @brief  Sets the SCLK frequency (writes CTRL[1]).
*
* @param  p     CcdController instance.
* @param  freq  CCDC_FREQ_100K (0) or CCDC_FREQ_500K (1); nonzero is treated as 500k.
******************************************************************************/
void CcdController_SetFreqSel(CcdController *p, u8 freq)
{
    u32 ctrl = CcdController_ReadReg(p, CCDC_REG_CTRL);
    if (freq) {
        ctrl |= CCDC_CTRL_FREQ_SEL_MASK;
    } else {
        ctrl &= ~CCDC_CTRL_FREQ_SEL_MASK;
    }
    CcdController_WriteReg(p, CCDC_REG_CTRL, ctrl);
}

/*****************************************************************************/
/**
* @brief  Sets mock mode (writes CTRL[2]).
*
* When enabled, the hardware replaces the real ADC data with virtual pixels.
*
* @param  p     CcdController instance.
* @param  mock  0 = real ADC data, 1 = mock virtual pixels.
******************************************************************************/
void CcdController_SetMockMode(CcdController *p, u8 mock)
{
    u32 ctrl = CcdController_ReadReg(p, CCDC_REG_CTRL);
    if (mock) {
        ctrl |= CCDC_CTRL_MOCK_MODE_MASK;
    } else {
        ctrl &= ~CCDC_CTRL_MOCK_MODE_MASK;
    }
    CcdController_WriteReg(p, CCDC_REG_CTRL, ctrl);
}

/*****************************************************************************/
/**
* @brief  Starts capture (sets exposure=1).
*
* Checks that DDR3 calibration is complete (STATUS[16]) before starting; returns
* XST_DEVICE_BUSY if not. Uses read-modify-write to keep the other CTRL bits
* (read_mode/freq/mock/cdsclk_delay etc.).
*
* @param  p  CcdController instance.
*
* @return XST_SUCCESS / XST_DEVICE_BUSY (DDR3 not calibrated yet).
******************************************************************************/
int CcdController_StartCapture(CcdController *p)
{
    u32 ctrl;

    if (!CcdController_IsDdrReady(p)) {
        return XST_FAILURE;
    }

    ctrl = CcdController_ReadReg(p, CCDC_REG_CTRL);
    ctrl |= CCDC_CTRL_EXPOSURE_MASK;
    CcdController_WriteReg(p, CCDC_REG_CTRL, ctrl);
    p->IsStarted = 1U;
    return XST_SUCCESS;
}

/*****************************************************************************/
/**
* @brief  Stops capture (clears exposure=0, falling edge starts readout).
*
* @param  p  CcdController instance.
******************************************************************************/
void CcdController_StopCapture(CcdController *p)
{
    u32 ctrl = CcdController_ReadReg(p, CCDC_REG_CTRL);
    ctrl &= ~CCDC_CTRL_EXPOSURE_MASK;
    CcdController_WriteReg(p, CCDC_REG_CTRL, ctrl);
    p->IsStarted = 0U;
}

/*****************************************************************************/
/**
* @brief  Triggers a frame send (writes TRIGGER[0]=1).
*
* The hardware stretches the trigger for one cycle then clears it; no readback needed.
*
* @param  p  CcdController instance.
******************************************************************************/
void CcdController_TriggerFrameSend(CcdController *p)
{
    CcdController_WriteReg(p, CCDC_REG_TRIGGER, CCDC_TRIGGER_TX_START_MASK);
}

/*****************************************************************************/
/**
* @brief  Soft-resets the whole CCD pipeline (writes CTRL[12]=1).
*
* The bit is a write-1 self-clearing pulse in hardware: it gates ccd_ddr's
* master reset (~41us stretched release), which resets the CCD driver, the DDR
* frame buffer and the frame sender, then re-locks the fixed frame length on
* the newly written image parameters. Used by the app after changing
* width/height/read_mode; the frame cache is flushed as part of the reset.
*
* Read-modify-write keeps the other CTRL bits unchanged.
*
* @param  p  CcdController instance.
******************************************************************************/
void CcdController_SoftReset(CcdController *p)
{
    u32 ctrl = CcdController_ReadReg(p, CCDC_REG_CTRL);
    ctrl |= CCDC_CTRL_SOFT_RESET_MASK;
    CcdController_WriteReg(p, CCDC_REG_CTRL, ctrl);
}

/*****************************************************************************/
/**
* @brief  Number of readable frames in the frame buffer (FRAME_NUM[0x1C], 32bit).
*
* The frame count has its own read-only register (since the MAX_FRAMES cache
* capacity can exceed the 8-bit field that used to live in STATUS[7:0]).
*
* @param  p  CcdController instance.
*
* @return Frame count, 0..MAX_FRAMES.
******************************************************************************/
u32 CcdController_GetFrameNum(CcdController *p)
{
    return CcdController_ReadReg(p, CCDC_REG_FRAME_NUM);
}

/*****************************************************************************/
/**
* @brief  Whether DDR3 calibration is complete (STATUS[16]).
*
* @param  p  CcdController instance.
*
* @return 1 = DDR3 ready, 0 = not ready.
******************************************************************************/
u8 CcdController_IsDdrReady(CcdController *p)
{
    return (CcdController_ReadReg(p, CCDC_REG_STATUS) &
            CCDC_STATUS_DDR3_DONE_MASK) ? 1U : 0U;
}

/*****************************************************************************/
/**
* @brief  Frame exception occurred (accumulated count > 0).
*         Legacy STATUS[8] bit removed; rely on the 16-bit counter STATUS[15:0].
*
* @param  p  CcdController instance.
*
* @return 1 = at least one frame exception occurred, 0 = none.
******************************************************************************/
u8 CcdController_GetException(CcdController *p)
{
    return CcdController_GetExceptionCnt(p) != 0U;
}

/*****************************************************************************/
/**
* @brief  Accumulated frame exception count (STATUS[15:0], 16-bit saturating).
*
* @param  p  CcdController instance.
*
* @return Number of accumulated frame exceptions.
******************************************************************************/
u32 CcdController_GetExceptionCnt(CcdController *p)
{
    return (CcdController_ReadReg(p, CCDC_REG_STATUS) &
            CCDC_STATUS_EXCEPTION_CNT);
}

/*****************************************************************************/
/**
* @brief  Reads the raw STATUS value (for debugging).
*
* @param  p  CcdController instance.
*
* @return Raw STATUS register contents.
******************************************************************************/
u32 CcdController_GetStatus(CcdController *p)
{
    return CcdController_ReadReg(p, CCDC_REG_STATUS);
}

/*****************************************************************************/
/**
* @brief  Registers the interrupt callback.
*
* @param  p    CcdController instance.
* @param  hdl  Callback invoked by CcdController_InterruptHandler; NULL disables.
* @param  ref  Opaque reference passed back to the callback.
******************************************************************************/
void CcdController_SetHandler(CcdController *p, CcdController_Handler hdl,
                              void *ref)
{
    p->Handler = hdl;
    p->CallBackRef = ref;
}

/*****************************************************************************/
/**
* @brief  Enables interrupts (writes INTR_EN).
*
* @param  p                  CcdController instance.
* @param  tx_done_en         Enable the TX_DONE interrupt (0/1).
* @param  exception_en       Enable the EXCEPTION interrupt (0/1).
* @param  frame_written_en   Enable the FRAME_WRITTEN interrupt (0/1)
*                            (one frame fully written to DDR = readout done).
******************************************************************************/
void CcdController_IntrEnable(CcdController *p, u8 tx_done_en,
                              u8 exception_en, u8 frame_written_en)
{
    u32 en = 0U;
    if (tx_done_en) {
        en |= CCDC_INTR_TX_DONE;
    }
    if (exception_en) {
        en |= CCDC_INTR_EXCEPTION;
    }
    if (frame_written_en) {
        en |= CCDC_INTR_FRAME_WRITTEN;
    }
    CcdController_WriteReg(p, CCDC_REG_INTR_EN, en);
}

/*****************************************************************************/
/**
* @brief  Disables all interrupts.
*
* @param  p  CcdController instance.
******************************************************************************/
void CcdController_IntrDisable(CcdController *p)
{
    CcdController_WriteReg(p, CCDC_REG_INTR_EN, 0U);
}

/*****************************************************************************/
/**
* @brief  ccd_controller ISR, hooked to the INTC.
*
* Reads INTR_STS -> masks with INTR_EN -> W1C clear -> calls back to the app
* (minimal processing).
*
* @param ref CcdController instance pointer.
******************************************************************************/
void CcdController_InterruptHandler(void *ref)
{
    CcdController *p = (CcdController *)ref;
    u32 en = CcdController_ReadReg(p, CCDC_REG_INTR_EN) & CCDC_INTR_ALL;
    u32 pending = CcdController_ReadReg(p, CCDC_REG_INTR_STS) & en;

    if (pending != 0U) {
        /* W1C: write 1 to clear */
        CcdController_WriteReg(p, CCDC_REG_INTR_STS, pending);
        if (p->Handler != NULL) {
            p->Handler(pending, p->CallBackRef);
        }
    }
}
