WenWeiCheng/S16011-CCD/02-fpga/ccd_controller_software/ccd_controller_app/src/hal/ccd_controller.h

/******************************************************************************
* @file ccd_controller.h
*
* Driver interface for the custom IP ccd_controller (AXI4-Lite).
*
* The names deliberately do not start with X (not Xilinx-provided), but the API style
* matches Xilinx drivers: Config lookup table + instance + CfgInitialize + SelfTest +
* InterruptHandler.
* Register map is in 00-docs/verilog-design/ccd_controller_ip.md.
*
* @note <pre>
* MODIFICATION HISTORY:
*
 * Ver   Who  Date     Changes
 * ----- ---- -------- -----------------------------------------------
 * 1.0   wwc  26/08/02 First release
 * 1.1   wwc  26/08/03 Complete function doc comments (Xilinx style)
 * 1.2   wwc  26/08/07 FRAME_NUM[0x1C] 独立寄存器 (32bit), GetFrameNum 返回 u32
 * 1.3   wwc  26/08/07 新增 FRAME_WRITTEN 中断 (INTR[10], 帧写入完成/读出完成)
 * 1.4   wwc  26/08/08 新增 CCDC_CTRL_SOFT_RESET_MASK (CTRL[12]) 与 SoftReset API
 * </pre>
******************************************************************************/
#ifndef CCD_CONTROLLER_H
#define CCD_CONTROLLER_H

#include "xil_types.h"
#include "xstatus.h"

#ifdef __cplusplus
extern "C" {
#endif

/******************************************************************************
* Register offsets and bit definitions (compare ccd_controller_ip.md)
******************************************************************************/
#define CCDC_REG_CTRL           0x00U   /* R/W */
#define CCDC_REG_IMG_SIZE       0x04U   /* R/W */
#define CCDC_REG_BEVEL_BLANK    0x08U   /* R/W */
#define CCDC_REG_TRIGGER        0x0CU   /* W  */
#define CCDC_REG_STATUS         0x10U   /* R  */
#define CCDC_REG_INTR_EN        0x14U   /* R/W */
#define CCDC_REG_INTR_STS       0x18U   /* W1C */
#define CCDC_REG_FRAME_NUM      0x1CU   /* R, 帧缓存可读帧数 (实时, 32bit) */

/* CTRL[0x00] */
#define CCDC_CTRL_EXPOSURE_MASK      (1U<<0)
#define CCDC_CTRL_FREQ_SEL_MASK      (1U<<1)   /* 0=100k, 1=500k */
#define CCDC_CTRL_MOCK_MODE_MASK     (1U<<2)
#define CCDC_CTRL_READ_MODE_MASK     (0x3U<<3) /* 0=line binning, 1=image */
#define CCDC_CTRL_CDSCLK_DELAY_MASK  (0x7FU<<5)
#define CCDC_CTRL_SOFT_RESET_MASK    (1U<<12)  /* W1 触发软复位自清脉冲 (位不存储, 读回恒 0) */

/* IMG_SIZE[0x04] */
#define CCDC_IMG_WIDTH_MASK      0x0000FFFFU
#define CCDC_IMG_HEIGHT_MASK     0xFFFF0000U

/* BEVEL_BLANK[0x08] */
#define CCDC_BEVEL_L_MASK        (0xFU<<0)
#define CCDC_BEVEL_T_MASK        (0xFU<<4)
#define CCDC_BEVEL_R_MASK        (0xFU<<8)
#define CCDC_BEVEL_B_MASK        (0xFU<<12)
#define CCDC_BLANK_L_MASK        (0xFU<<16)
#define CCDC_BLANK_R_MASK        (0xFU<<20)

/* TRIGGER[0x0C] */
#define CCDC_TRIGGER_TX_START_MASK  (1U<<0)

/* STATUS[0x10] */
#define CCDC_STATUS_EXCEPTION_CNT    (0xFFFFU)          /* [15:0] 16-bit saturating count */
#define CCDC_STATUS_DDR3_DONE_MASK   (1U<<16)

/* INTR_EN[0x14] / INTR_STS[0x18] */
#define CCDC_INTR_EXCEPTION       (1U<<8)
#define CCDC_INTR_TX_DONE         (1U<<9)
#define CCDC_INTR_FRAME_WRITTEN   (1U<<10)   /* 一帧完整写入 DDR (读出完成) */
#define CCDC_INTR_ALL             (CCDC_INTR_EXCEPTION | CCDC_INTR_TX_DONE | \
                                   CCDC_INTR_FRAME_WRITTEN)

/* Readout modes */
#define CCDC_READ_MODE_LINE_BINNING  0U
#define CCDC_READ_MODE_IMAGE         1U

/* Sampling frequencies */
#define CCDC_FREQ_100K               0U
#define CCDC_FREQ_500K               1U

/******************************************************************************
* Type definitions
******************************************************************************/
typedef struct {
    u16 DeviceId;
    u32 BaseAddress;
    u32 IntrVecId;            /* INTC vector number */
} CcdController_Config;

/* Bevel/blank parameters (correspond to the BEVEL_BLANK register) */
typedef struct {
    u8 BevelLeft;   /* [3:0]   */
    u8 BevelTop;    /* [7:4]   */
    u8 BevelRight;  /* [11:8]  */
    u8 BevelBottom; /* [15:12] */
    u8 BlankLeft;   /* [19:16] */
    u8 BlankRight;  /* [23:20] */
} CcdController_BevelBlank;

/* Interrupt callback: IntrMask is a combination of CCDC_INTR_* */
typedef void (*CcdController_Handler)(u32 IntrMask, void *CallBackRef);

typedef struct {
    CcdController_Config Config;
    u32  BaseAddress;
    u8   IsReady;
    u8   IsStarted;
    CcdController_Handler Handler;
    void *CallBackRef;
} CcdController;

/******************************************************************************
* Register-level access (static inline)
******************************************************************************/
static inline u32 CcdController_ReadReg(CcdController *p, u32 off)
{
    return *(volatile u32 *)(p->BaseAddress + off);
}

static inline void CcdController_WriteReg(CcdController *p, u32 off, u32 val)
{
    *(volatile u32 *)(p->BaseAddress + off) = val;
}

/******************************************************************************
* Initialization / self-test
******************************************************************************/
CcdController_Config *CcdController_LookupConfig(u16 DeviceId);
int CcdController_CfgInitialize(CcdController *p, CcdController_Config *cfg,
                                u32 addr);
int CcdController_SelfTest(CcdController *p);

/******************************************************************************
* Configuration semantic APIs (compare IP registers 0x00~0x08)
******************************************************************************/
void CcdController_SetImageSize(CcdController *p, u16 w, u16 h);
void CcdController_SetBevelBlank(CcdController *p,
                                 const CcdController_BevelBlank *bb);
void CcdController_SetCdsclkDelay(CcdController *p, u8 delay);
void CcdController_SetReadMode(CcdController *p, u8 mode);
void CcdController_SetFreqSel(CcdController *p, u8 freq);
void CcdController_SetMockMode(CcdController *p, u8 mock);

/******************************************************************************
* Capture control semantic APIs
******************************************************************************/
int CcdController_StartCapture(CcdController *p);  /* checks ddr3_done, then sets exposure=1 */
void CcdController_StopCapture(CcdController *p);   /* clears exposure=0 (falling edge starts readout) */
void CcdController_TriggerFrameSend(CcdController *p); /* writes TRIGGER[0]=1 */
void CcdController_SoftReset(CcdController *p);     /* writes CTRL[12]=1: 总复位整条 CCD 流水线 (帧长重锁) */

/******************************************************************************
* Status queries
******************************************************************************/
u32  CcdController_GetFrameNum(CcdController *p);   /* FRAME_NUM[0x1C] (32bit) */
u8   CcdController_IsDdrReady(CcdController *p);
u8   CcdController_GetException(CcdController *p);
u32  CcdController_GetExceptionCnt(CcdController *p);
u32  CcdController_GetStatus(CcdController *p);

/******************************************************************************
* Interrupts
******************************************************************************/
void CcdController_SetHandler(CcdController *p, CcdController_Handler hdl,
                              void *ref);
void CcdController_IntrEnable(CcdController *p, u8 tx_done_en,
                              u8 exception_en, u8 frame_written_en);
void CcdController_IntrDisable(CcdController *p);
void CcdController_InterruptHandler(void *ref);

#ifdef __cplusplus
}
#endif

#endif /* CCD_CONTROLLER_H */
