WenWeiCheng/S16011-CCD/02-fpga/ccd_controller_software/ccd_controller_app/src/logic/proto_num.c

/******************************************************************************
* @file proto_num.c
*
* Protocol number/set parsing and formatting implementation (pure logic, host-testable
* standalone).
*
* @note <pre>
* MODIFICATION HISTORY:
*
* Ver   Who  Date     Changes
* ----- ---- -------- -----------------------------------------------
* 1.0   wwc  26/08/03 First release
* 1.1   wwc  26/08/03 Complete function doc comments (Xilinx style)
* </pre>
******************************************************************************/
#include "proto_num.h"
#include <string.h>

/*****************************************************************************/
/**
* @brief  Unsigned decimal -> buf (without NUL), returns the length.
*
* @param  buf  Destination buffer (caller-provided, must fit the number).
* @param  v    Unsigned value to format.
*
* @return Number of digits written (excluding NUL).
******************************************************************************/
u32 Proto_Utoa(char *buf, u32 v)
{
    char tmp[12];
    u32 n = 0U, i;

    do {
        tmp[n++] = (char)('0' + (v % 10U));
        v /= 10U;
    } while (v != 0U);
    for (i = 0U; i < n; i++) {
        buf[i] = tmp[n - 1U - i];
    }
    buf[n] = '\0';
    return n;
}

/*****************************************************************************/
/**
* @brief  Signed decimal -> buf (with minus sign), returns the length.
*
* @param  buf  Destination buffer (caller-provided, must fit the number).
* @param  v    Signed value to format.
*
* @return Number of characters written (excluding NUL).
******************************************************************************/
u32 Proto_Itoa(char *buf, s32 v)
{
    u32 n = 0U;
    if (v < 0) {
        buf[n++] = '-';
        v = -v;
    }
    return n + Proto_Utoa(buf + n, (u32)v);
}

/*****************************************************************************/
/**
* @brief  Decimal string -> s32; the whole string must be valid.
*
* @param  s    NUL-terminated decimal string (optional leading +/-).
* @param  out  Receives the parsed value.
*
* @return 0 on success, -1 on malformed input.
******************************************************************************/
int Proto_ParseInt(const char *s, s32 *out)
{
    s32 v = 0;
    int neg = 0;
    const char *p = s;

    if (*p == '-') { neg = 1; p++; }
    else if (*p == '+') { p++; }
    if (*p == '\0') return -1;
    while (*p != '\0') {
        if (*p < '0' || *p > '9') return -1;
        v = v * 10 + (s32)(*p - '0');
        p++;
    }
    *out = neg ? -v : v;
    return 0;
}

/*****************************************************************************/
/**
* @brief  Decimal string -> u32; the whole string must be valid.
*
* @param  s    NUL-terminated decimal string (no sign).
* @param  out  Receives the parsed value.
*
* @return 0 on success, -1 on malformed input.
******************************************************************************/
int Proto_ParseUInt(const char *s, u32 *out)
{
    u32 v = 0;
    const char *p = s;
    if (*p == '\0') return -1;
    while (*p != '\0') {
        if (*p < '0' || *p > '9') return -1;
        v = v * 10U + (u32)(*p - '0');
        p++;
    }
    *out = v;
    return 0;
}

/*****************************************************************************/
/**
* @brief  Decimal floating-point string -> float; the whole string must be valid (supports
* fractions, no scientific notation).
*
* @param  s    NUL-terminated decimal string (optional leading +/- and one '.').
* @param  out  Receives the parsed value.
*
* @return 0 on success, -1 on malformed input.
******************************************************************************/
int Proto_ParseFloat(const char *s, float *out)
{
    float v = 0.0f;
    float scale = 1.0f;
    int neg = 0, dot = 0;
    const char *p = s;

    if (*p == '-') { neg = 1; p++; }
    else if (*p == '+') { p++; }
    if (*p == '\0') return -1;
    while (*p != '\0') {
        if (*p == '.') {
            if (dot) return -1;
            dot = 1;
            p++;
            continue;
        }
        if (*p < '0' || *p > '9') return -1;
        if (dot) {
            scale *= 10.0f;
            v += (float)(*p - '0') / scale;
        } else {
            v = v * 10.0f + (float)(*p - '0');
        }
        p++;
    }
    *out = neg ? -v : v;
    return 0;
}

/*****************************************************************************/
/**
* @brief  Fixed-point formatting: dec decimal places (0..5), rounded, supports negatives,
* avoids -0.
*
* @param  buf  Destination buffer.
* @param  cap  Buffer capacity in bytes.
* @param  v    Value to format.
* @param  dec  Decimal places, clamped to 0..5.
******************************************************************************/
void Proto_FmtFloat(char *buf, u32 cap, float v, int dec)
{
    long ip, fp, scale = 1L;
    u32 n = 0U;
    int i, neg = 0;

    if (dec < 0) dec = 0;
    if (dec > 5) dec = 5;
    for (i = 0; i < dec; i++) scale *= 10L;

    if (v < 0.0f) { neg = 1; v = -v; }
    ip = (long)v;
    if (dec > 0) {
        fp = (long)((v - (float)ip) * (float)scale + 0.5f);
        if (fp >= scale) { fp -= scale; ip++; }   /* fractional carry */
    } else {
        fp = 0L;
    }

    if (neg && (ip != 0L || fp != 0L)) {
        buf[n++] = '-';
    }
    n += Proto_Utoa(buf + n, (u32)ip);
    if (dec > 0) {
        char tmp[8];
        u32 m, z;
        if (n + 1U < cap) buf[n++] = '.';
        m = Proto_Utoa(tmp, (u32)fp);
        for (z = m; z < (u32)dec; z++) {          /* pad leading zeros */
            if (n + 1U < cap) buf[n++] = '0';
        }
        for (z = 0U; z < m; z++) {
            if (n + 1U < cap) buf[n++] = tmp[z];
        }
    }
    if (n >= cap) n = cap - 1U;
    buf[n] = '\0';
}

/*****************************************************************************/
/**
* @brief  Parses "min:max:step" (int).
*
* @param  c    Constraint string.
* @param  mn   Receives the minimum.
* @param  mx   Receives the maximum.
* @param  st   Receives the step.
*
* @return 0 on success, -1 on malformed input or if max < min / step <= 0.
******************************************************************************/
int Proto_ParseIntConstraint(const char *c, long *mn, long *mx, long *st)
{
    char seg[16];
    s32 a, b, d;
    const char *p1 = c, *p2;

    p2 = strchr(p1, ':');
    if (p2 == NULL || p2 == p1) return -1;
    memcpy(seg, p1, (size_t)(p2 - p1));
    seg[p2 - p1] = '\0';
    if (Proto_ParseInt(seg, &a) != 0) return -1;

    p1 = p2 + 1;
    p2 = strchr(p1, ':');
    if (p2 == NULL || p2 == p1) return -1;
    memcpy(seg, p1, (size_t)(p2 - p1));
    seg[p2 - p1] = '\0';
    if (Proto_ParseInt(seg, &b) != 0) return -1;

    p1 = p2 + 1;
    if (*p1 == '\0') return -1;
    if (Proto_ParseInt(p1, &d) != 0) return -1;

    if (b < a || d <= 0) return -1;
    *mn = a; *mx = b; *st = d;
    return 0;
}

/*****************************************************************************/
/**
* @brief  Parses "min:max:step" (float).
*
* @param  c    Constraint string.
* @param  mn   Receives the minimum.
* @param  mx   Receives the maximum.
* @param  st   Receives the step.
*
* @return 0 on success, -1 on malformed input or if max < min / step <= 0.
******************************************************************************/
int Proto_ParseFloatConstraint(const char *c, float *mn, float *mx, float *st)
{
    char seg[16];
    float a, b, d;
    const char *p1 = c, *p2;

    p2 = strchr(p1, ':');
    if (p2 == NULL || p2 == p1) return -1;
    memcpy(seg, p1, (size_t)(p2 - p1));
    seg[p2 - p1] = '\0';
    if (Proto_ParseFloat(seg, &a) != 0) return -1;

    p1 = p2 + 1;
    p2 = strchr(p1, ':');
    if (p2 == NULL || p2 == p1) return -1;
    memcpy(seg, p1, (size_t)(p2 - p1));
    seg[p2 - p1] = '\0';
    if (Proto_ParseFloat(seg, &b) != 0) return -1;

    p1 = p2 + 1;
    if (*p1 == '\0') return -1;
    if (Proto_ParseFloat(p1, &d) != 0) return -1;

    if (b < a || d <= 0.0f) return -1;
    *mn = a; *mx = b; *st = d;
    return 0;
}

/*****************************************************************************/
/**
* @brief  Decimal places of the step in a constraint string like "0:2.500:0.001"
* -> output precision.
*
* @param  constraint  Constraint string ending with "min:max:step".
*
* @return Number of decimal places of the step (0 if none).
******************************************************************************/
int Proto_StepDecimals(const char *constraint)
{
    const char *step = strrchr(constraint, ':');
    const char *dot;

    if (step == NULL) return 0;
    step++;
    dot = strchr(step, '.');
    if (dot == NULL) return 0;
    return (int)strlen(dot + 1);
}

/*****************************************************************************/
/**
* @brief  Number of items in a comma-separated list.
*
* @param  list  Comma-separated label list (non-empty).
*
* @return Item count (>= 1).
******************************************************************************/
u32 Proto_EnumCount(const char *list)
{
    u32 n = 1U;
    while ((list = strchr(list, ',')) != NULL) {
        n++;
        list++;
    }
    return n;
}

/*****************************************************************************/
/**
* @brief  Copies the idx-th comma-separated label into buf.
*
* @param  list  Comma-separated label list.
* @param  idx   Zero-based label index.
* @param  buf   Destination buffer.
* @param  cap   Buffer capacity in bytes.
*
* @return 0 on success, -1 if idx is out of range.
******************************************************************************/
int Proto_EnumLabel(const char *list, u32 idx, char *buf, u32 cap)
{
    const char *p = list;
    u32 i, n;

    for (i = 0; i < idx; i++) {
        p = strchr(p, ',');
        if (p == NULL) return -1;
        p++;
    }
    n = 0U;
    while (p[n] != '\0' && p[n] != ',') n++;
    if (n >= cap) n = cap - 1U;
    memcpy(buf, p, n);
    buf[n] = '\0';
    return 0;
}

/*****************************************************************************/
/**
* @brief  Matches a label -> enum index.
*
* @param  list  Comma-separated label list.
* @param  tok   Token to match (exact, case-sensitive).
* @param  out   Receives the matched index.
*
* @return 0 on match, -1 if not found.
******************************************************************************/
int Proto_ParseEnum(const char *list, const char *tok, s32 *out)
{
    u32 i, cnt = Proto_EnumCount(list);
    char buf[32];

    for (i = 0; i < cnt; i++) {
        if (Proto_EnumLabel(list, i, buf, sizeof buf) == 0 &&
            strcmp(buf, tok) == 0) {
            *out = (s32)i;
            return 0;
        }
    }
    return -1;
}

/*****************************************************************************/
/**
* @brief  Group filter: tec_* prefix matching, otherwise exact matching.
*
* @param  name   Parameter name to test.
* @param  group  Group filter (may end with '*').
*
* @return 1 = name matches the group, 0 = no match.
******************************************************************************/
int Proto_MatchGroup(const char *name, const char *group)
{
    u32 glen = (u32)strlen(group);
    if (glen > 0 && group[glen - 1] == '*') {
        return strncmp(name, group, glen - 1) == 0;
    }
    return strcmp(name, group) == 0;
}
