WenWeiCheng/S16011-CCD/02-fpga/ccd_controller_hardware/ip/ccd_controller/ccd_controller.srcs/sources_1/ip/mig_7series_0/mig_7series_0_stub.vhdl

-- Copyright 1986-2020 Xilinx, Inc. All Rights Reserved.
-- --------------------------------------------------------------------------------
-- Tool Version: Vivado v.2020.1 (win64) Build 2902540 Wed May 27 19:54:49 MDT 2020
-- Date        : Sun Jul 26 16:02:51 2026
-- Host        : DESKTOP-KD2H86C running 64-bit major release  (build 9200)
-- Command     : write_vhdl -force -mode synth_stub
--               d:/2607-Pro-S16011-CCD/02-fpga/ccd_controller_hardware/ip/ccd_controller/ccd_controller.srcs/sources_1/ip/mig_7series_0/mig_7series_0_stub.vhdl
-- Design      : mig_7series_0
-- Purpose     : Stub declaration of top-level module interface
-- Device      : xc7a100tfgg484-2
-- --------------------------------------------------------------------------------
library IEEE;
use IEEE.STD_LOGIC_1164.ALL;

entity mig_7series_0 is
  Port ( 
    ddr3_dq : inout STD_LOGIC_VECTOR ( 31 downto 0 );
    ddr3_dqs_n : inout STD_LOGIC_VECTOR ( 3 downto 0 );
    ddr3_dqs_p : inout STD_LOGIC_VECTOR ( 3 downto 0 );
    ddr3_addr : out STD_LOGIC_VECTOR ( 14 downto 0 );
    ddr3_ba : out STD_LOGIC_VECTOR ( 2 downto 0 );
    ddr3_ras_n : out STD_LOGIC;
    ddr3_cas_n : out STD_LOGIC;
    ddr3_we_n : out STD_LOGIC;
    ddr3_reset_n : out STD_LOGIC;
    ddr3_ck_p : out STD_LOGIC_VECTOR ( 0 to 0 );
    ddr3_ck_n : out STD_LOGIC_VECTOR ( 0 to 0 );
    ddr3_cke : out STD_LOGIC_VECTOR ( 0 to 0 );
    ddr3_cs_n : out STD_LOGIC_VECTOR ( 0 to 0 );
    ddr3_dm : out STD_LOGIC_VECTOR ( 3 downto 0 );
    ddr3_odt : out STD_LOGIC_VECTOR ( 0 to 0 );
    sys_clk_i : in STD_LOGIC;
    clk_ref_i : in STD_LOGIC;
    ui_clk : out STD_LOGIC;
    ui_clk_sync_rst : out STD_LOGIC;
    mmcm_locked : out STD_LOGIC;
    aresetn : in STD_LOGIC;
    app_sr_req : in STD_LOGIC;
    app_ref_req : in STD_LOGIC;
    app_zq_req : in STD_LOGIC;
    app_sr_active : out STD_LOGIC;
    app_ref_ack : out STD_LOGIC;
    app_zq_ack : out STD_LOGIC;
    s_axi_awid : in STD_LOGIC_VECTOR ( 3 downto 0 );
    s_axi_awaddr : in STD_LOGIC_VECTOR ( 29 downto 0 );
    s_axi_awlen : in STD_LOGIC_VECTOR ( 7 downto 0 );
    s_axi_awsize : in STD_LOGIC_VECTOR ( 2 downto 0 );
    s_axi_awburst : in STD_LOGIC_VECTOR ( 1 downto 0 );
    s_axi_awlock : in STD_LOGIC_VECTOR ( 0 to 0 );
    s_axi_awcache : in STD_LOGIC_VECTOR ( 3 downto 0 );
    s_axi_awprot : in STD_LOGIC_VECTOR ( 2 downto 0 );
    s_axi_awqos : in STD_LOGIC_VECTOR ( 3 downto 0 );
    s_axi_awvalid : in STD_LOGIC;
    s_axi_awready : out STD_LOGIC;
    s_axi_wdata : in STD_LOGIC_VECTOR ( 127 downto 0 );
    s_axi_wstrb : in STD_LOGIC_VECTOR ( 15 downto 0 );
    s_axi_wlast : in STD_LOGIC;
    s_axi_wvalid : in STD_LOGIC;
    s_axi_wready : out STD_LOGIC;
    s_axi_bready : in STD_LOGIC;
    s_axi_bid : out STD_LOGIC_VECTOR ( 3 downto 0 );
    s_axi_bresp : out STD_LOGIC_VECTOR ( 1 downto 0 );
    s_axi_bvalid : out STD_LOGIC;
    s_axi_arid : in STD_LOGIC_VECTOR ( 3 downto 0 );
    s_axi_araddr : in STD_LOGIC_VECTOR ( 29 downto 0 );
    s_axi_arlen : in STD_LOGIC_VECTOR ( 7 downto 0 );
    s_axi_arsize : in STD_LOGIC_VECTOR ( 2 downto 0 );
    s_axi_arburst : in STD_LOGIC_VECTOR ( 1 downto 0 );
    s_axi_arlock : in STD_LOGIC_VECTOR ( 0 to 0 );
    s_axi_arcache : in STD_LOGIC_VECTOR ( 3 downto 0 );
    s_axi_arprot : in STD_LOGIC_VECTOR ( 2 downto 0 );
    s_axi_arqos : in STD_LOGIC_VECTOR ( 3 downto 0 );
    s_axi_arvalid : in STD_LOGIC;
    s_axi_arready : out STD_LOGIC;
    s_axi_rready : in STD_LOGIC;
    s_axi_rid : out STD_LOGIC_VECTOR ( 3 downto 0 );
    s_axi_rdata : out STD_LOGIC_VECTOR ( 127 downto 0 );
    s_axi_rresp : out STD_LOGIC_VECTOR ( 1 downto 0 );
    s_axi_rlast : out STD_LOGIC;
    s_axi_rvalid : out STD_LOGIC;
    init_calib_complete : out STD_LOGIC;
    device_temp : out STD_LOGIC_VECTOR ( 11 downto 0 );
    sys_rst : in STD_LOGIC
  );

end mig_7series_0;

architecture stub of mig_7series_0 is
attribute syn_black_box : boolean;
attribute black_box_pad_pin : string;
attribute syn_black_box of stub : architecture is true;
attribute black_box_pad_pin of stub : architecture is "ddr3_dq[31:0],ddr3_dqs_n[3:0],ddr3_dqs_p[3:0],ddr3_addr[14:0],ddr3_ba[2:0],ddr3_ras_n,ddr3_cas_n,ddr3_we_n,ddr3_reset_n,ddr3_ck_p[0:0],ddr3_ck_n[0:0],ddr3_cke[0:0],ddr3_cs_n[0:0],ddr3_dm[3:0],ddr3_odt[0:0],sys_clk_i,clk_ref_i,ui_clk,ui_clk_sync_rst,mmcm_locked,aresetn,app_sr_req,app_ref_req,app_zq_req,app_sr_active,app_ref_ack,app_zq_ack,s_axi_awid[3:0],s_axi_awaddr[29:0],s_axi_awlen[7:0],s_axi_awsize[2:0],s_axi_awburst[1:0],s_axi_awlock[0:0],s_axi_awcache[3:0],s_axi_awprot[2:0],s_axi_awqos[3:0],s_axi_awvalid,s_axi_awready,s_axi_wdata[127:0],s_axi_wstrb[15:0],s_axi_wlast,s_axi_wvalid,s_axi_wready,s_axi_bready,s_axi_bid[3:0],s_axi_bresp[1:0],s_axi_bvalid,s_axi_arid[3:0],s_axi_araddr[29:0],s_axi_arlen[7:0],s_axi_arsize[2:0],s_axi_arburst[1:0],s_axi_arlock[0:0],s_axi_arcache[3:0],s_axi_arprot[2:0],s_axi_arqos[3:0],s_axi_arvalid,s_axi_arready,s_axi_rready,s_axi_rid[3:0],s_axi_rdata[127:0],s_axi_rresp[1:0],s_axi_rlast,s_axi_rvalid,init_calib_complete,device_temp[11:0],sys_rst";
begin
end;
