WenWeiCheng/S16011-CCD/02-fpga/ccd_controller_hardware/ip/ccd_controller/ccd_controller.srcs/sources_1/ip/rd_ddr3_fifo/rd_ddr3_fifo_stub.vhdl

-- Copyright 1986-2020 Xilinx, Inc. All Rights Reserved.
-- --------------------------------------------------------------------------------
-- Tool Version: Vivado v.2020.1 (win64) Build 2902540 Wed May 27 19:54:49 MDT 2020
-- Date        : Sun Jul 26 15:56:15 2026
-- Host        : DESKTOP-KD2H86C running 64-bit major release  (build 9200)
-- Command     : write_vhdl -force -mode synth_stub -rename_top rd_ddr3_fifo -prefix
--               rd_ddr3_fifo_ rd_ddr3_fifo_stub.vhdl
-- Design      : rd_ddr3_fifo
-- Purpose     : Stub declaration of top-level module interface
-- Device      : xc7a100tfgg484-2
-- --------------------------------------------------------------------------------
library IEEE;
use IEEE.STD_LOGIC_1164.ALL;

entity rd_ddr3_fifo is
  Port ( 
    rst : in STD_LOGIC;
    wr_clk : in STD_LOGIC;
    rd_clk : in STD_LOGIC;
    din : in STD_LOGIC_VECTOR ( 127 downto 0 );
    wr_en : in STD_LOGIC;
    rd_en : in STD_LOGIC;
    dout : out STD_LOGIC_VECTOR ( 15 downto 0 );
    full : out STD_LOGIC;
    empty : out STD_LOGIC;
    rd_data_count : out STD_LOGIC_VECTOR ( 8 downto 0 );
    wr_data_count : out STD_LOGIC_VECTOR ( 5 downto 0 );
    wr_rst_busy : out STD_LOGIC;
    rd_rst_busy : out STD_LOGIC
  );

end rd_ddr3_fifo;

architecture stub of rd_ddr3_fifo is
attribute syn_black_box : boolean;
attribute black_box_pad_pin : string;
attribute syn_black_box of stub : architecture is true;
attribute black_box_pad_pin of stub : architecture is "rst,wr_clk,rd_clk,din[127:0],wr_en,rd_en,dout[15:0],full,empty,rd_data_count[8:0],wr_data_count[5:0],wr_rst_busy,rd_rst_busy";
attribute x_core_info : string;
attribute x_core_info of stub : architecture is "fifo_generator_v13_2_5,Vivado 2020.1";
begin
end;
