WenWeiCheng/S16011-CCD/02-fpga/ccd_controller_hardware/ip/ccd_controller/ccd_controller.srcs/src/test_ccd_frame_buf_ddr.v

`timescale 1ns / 1ps
//==============================================================================
// Testbench : test_ccd_frame_buf_ddr
// Desc      : ccd_frame_buf_ddr 顶层模块的完整仿真 testbench
//
// 架构:
//   DUT (ccd_frame_buf_ddr) 内部已封装:
//     ccd_frame_buf_ddr_ctrl (控制逻辑 + wr/rd FIFO + AXI adapter)
//     mig_7series_0 (Xilinx MIG IP)
//
//   Testbench 负责:
//     - 驱动 ADC 时钟域 (i_adcclk): 模拟 CCD 像素数据输入
//     - 驱动 RD 时钟域 (i_rd_clk):  模拟 FX2 读回数据
//     - 例化 DDR3 仿真模型 (ddr3_model × 2: 32-bit → 2×16-bit)
//     - 自检验证写入/读回数据一致性
//
//   FIFO 约束:
//     Xilinx FIFO 实际可用深度 = 配置深度 - 1, 因此:
//       wr_ddr3_fifo: 写侧实际 511 (配置512), 读侧实际 63 (配置64)
//       rd_ddr3_fifo: 写侧实际 63  (配置64),  读侧实际 511 (配置512)
//     测试用例中单帧像素数不应设为 512 的整数倍, 以避免触碰 FIFO 写侧深度边界。
//==============================================================================
module test_ccd_frame_buf_ddr;

    // ==================================================================
    // 参数 (缩减以加速仿真)
    // ==================================================================
    localparam MAX_FRAMES       = 4;
    localparam MAX_FRAME_DEPTH  = 2048;

    localparam ADC_CLK_PERIOD   = 20;     // 50 MHz
    localparam RD_CLK_PERIOD    = 20;     // 50 MHz (与 ADC 异步)
    localparam DDR3_CLK100_PER  = 10;     // 100 MHz
    localparam DDR3_CLK200_PER  = 5;      // 200 MHz ref

    localparam BURST_UNITS      = 32;     // AXI_BURST_LEN + 1
    localparam PIXELS_PER_BURST = BURST_UNITS * 8;  // 256 像素/burst
    localparam FRAME_NUM_W      = $clog2(MAX_FRAMES + 1);

    // ==================================================================
    // 时钟
    // ==================================================================
    reg i_adcclk;
    reg i_rd_clk;
    reg mig_sys_clk;
    reg mig_clk_ref;

    initial i_adcclk = 1'b0;
    always #(ADC_CLK_PERIOD/2) i_adcclk = ~i_adcclk;

    initial i_rd_clk = 1'b0;
    always #(RD_CLK_PERIOD/2) i_rd_clk = ~i_rd_clk;

    initial mig_sys_clk = 1'b0;
    always #(DDR3_CLK100_PER/2) mig_sys_clk = ~mig_sys_clk;

    initial mig_clk_ref = 1'b0;
    always #(DDR3_CLK200_PER/2) mig_clk_ref = ~mig_clk_ref;

    // ==================================================================
    // 复位与 DUT 控制
    // ==================================================================
    reg i_rst_n;
    reg mig_rst_n;   // MIG 专用复位, 独立于 i_rst_n

    // ==================================================================
    // ADC 域信号 (i_adcclk)
    // ==================================================================
    reg  [15:0] i_wr_data;
    reg         i_wr_en;
    reg  [1:0]  i_pixel_type;
    reg         i_frame_start;
    reg         i_frame_end;
    reg  [15:0] i_image_width;
    reg  [15:0] i_image_height;
    reg  [1:0]  i_read_mode;

    // ==================================================================
    // RD 域信号 (i_rd_clk) — 来自 DUT 输出
    // ==================================================================
    wire [15:0]                   o_fifo_data;
    wire [FRAME_NUM_W-1:0]        o_frame_num;
    reg                           i_fifo_rd_en;
    wire                          o_fifo_prelast;

    // ==================================================================
    // 异常 / 状态
    // ==================================================================
    wire o_frame_exception;

    // ---- MIG 接口 (ui_clk 域) ----
    wire        ui_clk;
    wire        ddr3_init_done;
    wire        mmcm_locked;
    wire        init_calib_complete;
    wire        ui_clk_sync_rst;
    // 控制器复位: 系统复位 AND DDR3 初始化完成 (ccd_frame_buf_ddr 不再内部门控)
    wire        ctrl_rst_n = i_rst_n && ddr3_init_done;

    // ==================================================================
    // DDR3 物理接口 (MIG ↔ ddr3_model)
    // ==================================================================
    wire [31:0]  ddr3_dq;
    wire [3:0]   ddr3_dqs_n;
    wire [3:0]   ddr3_dqs_p;
    wire [14:0]  ddr3_addr;
    wire [2:0]   ddr3_ba;
    wire         ddr3_ras_n;
    wire         ddr3_cas_n;
    wire         ddr3_we_n;
    wire         ddr3_reset_n;
    wire [0:0]   ddr3_ck_p;
    wire [0:0]   ddr3_ck_n;
    wire [0:0]   ddr3_cke;
    wire [0:0]   ddr3_cs_n;
    wire [3:0]   ddr3_dm;
    wire [0:0]   ddr3_odt;

    // ---- AXI4 互连 (DUT M_AXI ↔ MIG S_AXI) ----
    wire [3:0]   axi_awid;
    wire [29:0]  axi_awaddr;
    wire [7:0]   axi_awlen;
    wire [2:0]   axi_awsize;
    wire [1:0]   axi_awburst;
    wire         axi_awlock;
    wire [3:0]   axi_awcache;
    wire [2:0]   axi_awprot;
    wire [3:0]   axi_awqos;
    wire         axi_awvalid;
    wire         axi_awready;
    wire [127:0] axi_wdata;
    wire [15:0]  axi_wstrb;
    wire         axi_wlast;
    wire         axi_wvalid;
    wire         axi_wready;
    wire [3:0]   axi_bid;
    wire [1:0]   axi_bresp;
    wire         axi_bvalid;
    wire         axi_bready;
    wire [3:0]   axi_arid;
    wire [29:0]  axi_araddr;
    wire [7:0]   axi_arlen;
    wire [2:0]   axi_arsize;
    wire [1:0]   axi_arburst;
    wire         axi_arlock;
    wire [3:0]   axi_arcache;
    wire [2:0]   axi_arprot;
    wire [3:0]   axi_arqos;
    wire         axi_arvalid;
    wire         axi_arready;
    wire [3:0]   axi_rid;
    wire [127:0] axi_rdata;
    wire [1:0]   axi_rresp;
    wire         axi_rlast;
    wire         axi_rvalid;
    wire         axi_rready;

    // ==================================================================
    // Scoreboard
    // ==================================================================
    reg  [15:0]  scoreboard [0:MAX_FRAMES-1][0:MAX_FRAME_DEPTH-1];

    // ==================================================================
    // 测试控制变量
    // ==================================================================
    integer      frame_i, pixel_i;
    reg   [7:0]  test_num;
    reg  [15:0]  last_img_width;
    reg  [15:0]  last_img_height;
    reg  [1:0]   last_read_mode;

    // ==================================================================
    // DUT 例化 (MIG 已移出, 通过 AXI4 接口连接)
    // ==================================================================
    ccd_frame_buf_ddr #(
        .MAX_FRAME_DEPTH (MAX_FRAME_DEPTH),
        .MAX_FRAMES      (MAX_FRAMES)
    ) u_dut (
        // ADC 域
        .i_wr_clk         (i_adcclk),
        .i_rst_n          (ctrl_rst_n),
        .i_wr_data        (i_wr_data),
        .i_wr_en          (i_wr_en),
        .i_pixel_type     (i_pixel_type),
        .i_frame_start    (i_frame_start),
        .i_frame_end      (i_frame_end),
        .i_image_width    (i_image_width),
        .i_image_height   (i_image_height),
        .i_read_mode      (i_read_mode),

        // RD 域
        .i_rd_clk         (i_rd_clk),
        .o_fifo_data      (o_fifo_data),
        .o_frame_num      (o_frame_num),
        .i_fifo_rd_en     (i_fifo_rd_en),
        .o_fifo_prelast (o_fifo_prelast),

        // 异常
        .o_frame_exception(o_frame_exception),
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
