WenWeiCheng/S16011-CCD/(commit log)

2026-07-08 chore: 初始化仓库，建立综合项目源码追踪
    - 新增 .gitignore：覆盖 Vivado/Vitis、Qt/CMake、Keil C51、PCB 等模块的构建产物
    - 纳入源码：README.md、01-pcb/ (BOM、旧驱动原理图)、02-fpga/ (Vivado 工程及 HDL 源)
    - 忽略参考项目 nir-proj-reference/（外部历史资料）
    [BOM.xlsx, CCD传感器驱动板_DAC8311_ADS1118.eprj]
2026-07-08 chore: 更新 .gitignore 以支持 Vivado 日志文件模式匹配；新增 AGENTS.md 文件以描述项目结构
2026-07-09 feat: 在 testbench 中添加 ccd 不同相位时钟的激励信号
2026-07-09 chore: 暂时不追踪 docs 目录
2026-07-11 feat: 实现CCD驱动模块(ccd_driver)及相位时钟生成器(ccd_phase_gen)
    - 部分实现 ccd_driver.v：包含三态状态机(IDLE/VERTICAL/HORIZONTAL)、曝光下降沿同步与展宽、频率切换检测、CCD驱动输出使能逻辑
    - 新增 ccd_phase_gen.v：基于计数器生成4相50%占空比SCLK和2相25%占空比RG，支持100kHz/500kHz切换
    - 重写testbench test_ccd_driver.v：实例化DUT，测试复位、line binning、image模式、exposure/freq_sel/rst_n打断共6项功能
    - 更新Vivado项目文件：添加ccd_phase_gen至源文件和仿真集，设置仿真顶层为test_ccd_driver，配置波形文件与运行时间
2026-07-11 feat: 在ccd_driver模块中添加像素数据有效信号和像素类型指示输出
2026-07-11 feat: 新增FPGA子项目AGENTS.md，规范目录结构、Verilog编码风格与测试平台；根AGENTS.md增加交叉引用
2026-07-11 fix: 修复Vivado项目文件中的文件顺序及重复引用问题
2026-07-11 docs: 将根AGENTS.md内容本地化为中文
2026-07-12 feat: 修正 h_counter 计数逻辑；在ccd_driver中添加ADC数据采样及16bit像素数据输出
2026-07-12 feat: 新增 cdsclk_gen 模块，在 ccd_driver 中集成 CDS 采样时钟
2026-07-13 feat: 新增异步FIFO、CCD控制器及乒乓帧缓存模块；ccd_driver增加帧边界信号；补全对应验证测试平台，并更新.gitignore忽略verilog中间文件
2026-07-13 refactor(ccd_frame_buf): 将乒乓帧缓存状态机从写域迁至读域，并建立完整跨时钟域CDC通路
2026-07-13 feat: 新增帧最后一字指示信号 (o_fifo_last_word) 及 ccd_frame_tx 帧发送模块
2026-07-13 feat(ccd): 集成 ccd_frame_tx 帧发送模块，对外提供 FX2 Slave FIFO 接口
2026-07-13 feat(ccd): 新增帧缓存帧数状态输出 o_frame_num
2026-07-16 refactor(ccd): 统一所有时钟域为上升沿触发，引入反相时钟替代下降沿逻辑
2026-07-16 feat: 添加 ddr3 mig ip 核
2026-07-16 feat: 添加 ddr3 mig ip 核 (2)
2026-07-16 feat: 添加 ddr3 mig ip 核 (3)
2026-07-16 feat(ccd): 帧缓存支持可配置帧数并输出帧计数，简化 async_fifo 输出
2026-07-16 feat(ccd): 顶层模块支持可配置最大帧数，简化帧缓存状态接口
2026-07-16 refactor(ccd_frame_buf): 移除未使用的输出端口 o_rd_fifo_sel
2026-07-16 feat(mig): 更新DDR3 MIG IP核配置，改用独立参考时钟并降低系统时钟至100MHz
2026-07-16 chore(xpr): 更新仿真配置，添加 mig_b.prj 并调整 testbench 顺序
2026-07-17 feat(fifo): 添加 ddr 的读写缓冲 fifo ip
2026-07-17 fix: 将所有 reg/wire/integer 声明统一前移到模块顶部，解决 ModelSim 报'使用未定义的变量'的问题
    [ccd_frame_tx.v, test_ccd_driver.v]
2026-07-22 feat: 添加 ddr 版本的 frame buffer
2026-07-22 chore: 修改 gitignore, 忽略 _tmp 和 ddr_test 目录
2026-07-22 fix(ddr, tx): 修正帧深度计数边界，连接 rdfifo_empty，简化 tx 数据管道
    [ccd_frame_buf_ddr_ctrl.v, ccd_frame_tx.v]
2026-07-22 feat(ddr): 切换项目到 ccd_ddr 顶层模块，添加联合仿真测试
2026-07-24 feat: 更改工程目录结构；添加 microblaze 子系统
2026-07-24 docs: 更新 AGENTS.md 反映最新工程目录及路径变更
2026-07-26 feat: 给 ccd_controllre 添加 fifo 和 mig ip
2026-07-26 refactor(clk, cdc): 合并ccd_phase_gen与cdsclk_gen为ccd_clk_gen，修复多时钟域复位同步
2026-07-26 feat(ccd_controller): 添加时钟约束
2026-07-26 refactor(test): 替换 ccd_clk_gen 测试台，修复 ccd_driver 测试参数
    [test_ccd_clk_gen.v, test_ccd_driver.v]
2026-07-26 feat(ccd_driver): 添加 mock 模式支持，输出递增虚拟像素数据
2026-07-27 refactor(ddr): 将 MIG DDR3 控制器由帧缓存内部移至外部，通过 AXI4 接口解耦
2026-07-27 refactor(frame_buf): 统一帧信号上升沿检测，重命名last_word为prelast，DDR控制器AXI解耦
2026-07-28 refacto: 将 MIG 初始化状态拆分为单独端口，重命名 o_frame_done_n 为 o_tx_last_n，新增系统级 AXI 测试台
2026-07-28 feat(ccd_controller): 添加完整CCD控制器IP（AXI4接口），封装成 IP
2026-08-02 refactor: 从 ccd_controller ip 中移除 M_AXI_CLK 输出端口
2026-08-02 feat: 添加 vitis 工程和 bsp 示例
2026-08-02 feat(ccd_controller_software): 实现驱动层 (HAL + app 芯片驱动)
    按 ccd_controller_driver_architecture.md 实现 ccd_controller_app 驱动层：
    - hal/: CcdController 自制 IP 驱动 + board_hal 全局实例/INTC 接线
    - app_drivers/: heartbeat/key/led/fx2/adn8833/ccd/uart/ads1118/dac8311/ad9826
    - include/: board_config.h 板级配置 (SPI 片选/GPIO 位映射/Vref/NTC 占位)
    - main.c: BoardHal_Init + 冒烟测试挂载占位
    SPI 无 FIFO(寄存器轮询)、共用总线按芯片切换 SPI mode；
    timer1 64-bit 级联曝光计时；UART 行缓冲收发；mb-gcc 2020.1 编译链接通过。
2026-08-03 feat(ccd_controller_software): 实现 UART 控制协议（app 逻辑层）
    - 新增 app_logic/：protocol（参数表 + 命令分发表 + 解析/响应 + ACQ）、
    monitor（ads1118 采样循环 + NTC 查表换算）、proto_num（纯数字/集合解析格式化）
    - main.c 装配 app 逻辑（UART 协议 + 遥测 + LED 心跳）
    - board_config.h 增补 S16011 几何默认值 + NTC/TEC 占位换算常量
    - lscript.ld 更新为 128KB local mem（栈/堆 16KB）
    - AGENTS.md 记录 mb-gcc 无头构建经验（newlib printf 体积教训、PowerShell 坑、纯逻辑主机单测）
2026-08-03 TB: 同步 ccd_controller AXI 测试台到 wrapper 端口 (去掉幽灵 M_AXI_CLK/i_ddr3_init_done, 补 i_rd_clk_n/o_slave_fifo_clk/i_mmcm_locked/i_init_calib_complete)
2026-08-03 TB: 新增异常中断回归测试, 断言 INTR_STS exception 读回 bit[8] 且 bit[7]=0, 验证 W1C
2026-08-03 RTL: 修正 INTR_STS 读回位错位, exception_pending 由 bit[7] 移至 bit[8], 与文档/头文件一致
    [ccd_controller_v1_0_S00_AXI.v]
2026-08-03 feat(ccd_controller_software): 协议值系统重构 + 驱动层注释英文化
    - protocol.c: int_collection 更名 enum (VAL_TYPE_ENUM)，移除未使用的 float_collection；
    值类型字符串 'enum'；参数越界 clamp、step 就近取整；全文件补充 Doxygen 注释
    - proto_num.c/h: Proto_Coll* 更名 Proto_Enum*（EnumCount/EnumLabel/ParseEnum）
    - 驱动层/配置/入口: 中文注释转英文（app_drivers, hal, board_config.h, main.c）
2026-08-03 RTL: 拆分从 FIFO 写使能与帧尾信号, IP 新增中断/输出时钟总线接口
2026-08-03 feat(ccd_controller_hardware): BD 集成 DDR3/SPI/IIC/定时器/自定义IP, 重排整板管脚并添加 ILA 调试
2026-08-03 feat(ccd_controller_software): 驱动/协议注释英文化 + 协议错误处理增强 + 新增 ad9826 配置参数
    - 全部驱动与协议函数补全 Doxygen 文档（英文）
    - 协议对 token 溢出/空行回 ERR，不再静默丢弃
    - UART 协议新增 adc_gain_r/g/b、adc_offset_r/g/b（ad9826 偏移码拓宽为 u16）
    - 更新软件 AGENTS.md、重新导出的 .mmi/.prj 与 .gitignore Vitis 产物规则（含 Debug/）
2026-08-03 chore(ccd_controller_software): 从 git 追踪中移除 Xilinx IP 驱动示例工程
    - git rm --cached 移除 12 个 *_example_1 / *_example_1_system 示例工程（55 个文件，保留磁盘）
    - .gitignore 新增 *_example_1/ 与 *_example_1_system/ 规则，并覆盖未追踪的 xspi_polled_example_1
2026-08-03 fix(ccd_controller_software): 修正 ads1118 NOP 字段, 写配置必须用 NOP=01b
    根据数据手册 (Table 7), 写 Config 寄存器要求 NOP[1:0]=01b, 否则为 NOP 命令不更新寄存器。
    原代码写配置用 00b, 导致 Init/SetChannel 的配置从未生效。现交换两值:
    - ADS1118_NOP_NORMAL (写配置) 由 0x0 改为 0x1
    - ADS1118_NOP_READ (取数) 由 0x1 改为 0x0
    同步更新 .c/.h 注释与修改历史。
    [ads1118.c, ads1118.h]
2026-08-03 fix(ccd_controller_software): SPI 初始化后禁用全局中断以使用轮询模式
    - .gitignore 增加 compile_commands.json、_ide/ 与 *docs/ 忽略规则
    [board_hal.c]
2026-08-03 docs: 更新仓库说明, 补充 FPGA 软硬件子项目与构建产物约定
2026-08-04 feat(ccd_controller_software): NTC 温度查询改为分通道查表, 新增表生成工具
    - 拆出 app_logic/ntc.c 通用查表模块(线性插值/双向钳位/零宽段跳过), 替换 monitor.c 内联实现
    - 传感器(AIN0)与环境(AIN3)通道各自独立 NTC 参数与查找表, 支持不同 NTC 器件/分压电阻
    - 新增 tools/gen_ntc_table.py 依据 board_config.h 的分压拓扑(Vref-R1-抽头-R2-Rntc-GND)离线生成 ntc_tables.h
    - board_config.h 改为按通道提供 R1/R2/R25/BETA/分压参考电压占位常量(TODO 待 BOM 确认)
2026-08-04 feat(ccd_controller_software): 实现 TEC 温度 PID 控温及 ADN8833 电压/电流换算
    - 新增纯逻辑模块 pid(通用 PID, 微分作用于测量值, 条件积分反卷绕) 与 tec(Vtec/Vcont/VVM/VIM 换算)
    - 新增 tec_ctrl 温度控制环路: 跟随传感器新样本(~32ms)运行 PID, 输出 Vtec(±3.3V) 钳位,
    经 Vcont 写 DAC8311, 使能/失能同时驱动 ADN8833 EN 引脚
    - 协议参数: tec_voltage_set 移除, 新增 tec_set_temp/tec_kp/tec_ki/tec_kd
    - tec_voltage/tec_current RO 改用 ADN8833 监测换算, 约束范围支持负值
    - monitor 增加每通道样本 tick 供环路判定新样本
    - board_config: 新增 ADN8833 换算常量与 PID 输出钳位范围
2026-08-04 feat(ccd_controller_software): UART 命令动词大小写不敏感, 方便调试输入
2026-08-04 chore: gitignore 忽略 *.mmi 构建产物
2026-08-04 refactor(ccd_controller_software): 重命名 app_drivers 为 devices、app_logic 为 logic
    - app_drivers/ 改名为 devices/, app_logic/ 改名为 logic/ (git mv, 保留历史)
    - 更新全部 include 路径 (main.c, hal/board_hal.h, logic/* 等)
    - board_hal.h 改用 devices/ccd.h 引入 CcdController (替代直接 include hal/ccd_controller.h)
    - 移除 BoardHal_Init 入口/出口的 xil_printf 调试打印
    - 同步更新注释路径: AGENTS.md, board_config.h, ntc_tables.h, gen_ntc_table.py
    - 用 mb-gcc 全量编译验证, 20 个 .c 文件全部通过
2026-08-06 refactor(ccd_controller_hardware): 梳理 CCD DDR 模块时钟与复位逻辑
    - ccd_ddr 的 i_clk 更名为 i_ccd_clk (仅用于 CCD 时序信号分频)
    - ccd_frame_buf_ddr / ccd_frame_buf_ddr_ctrl 的写侧时钟 i_adcclk 更名为 i_wr_clk, 与 i_rd_clk 对应
    - ccd_frame_buf_ddr_ctrl 内部 *_adc 信号及 i_adcclk 域注释统一改为 *_wr / i_wr_clk 域
    - ctrl_rst_n = i_rst_n && ddr3_init_done 移入 ccd_ddr, 供 ccd_driver / ccd_frame_buf_ddr / ccd_frame_tx 共享
    - ccd_frame_buf_ddr 移除 i_ddr3_init_done 端口, 直接用 ccd_ddr 传入的复位
2026-08-06 refactor(ccd_controller_hardware): 移除 tb 目录, 测试文件迁入 ip/ccd_controller/src
    测试文件已随 IP 源一同纳入 ip/ccd_controller/ccd_controller.srcs/src/, 删除原 tb/ 下的重复副本
2026-08-06 refactor(ccd_controller_hardware): 移除 rtl 目录, RTL 源文件迁入 ip/ccd_controller/src
    可综合 RTL 源码已统一纳入 ip/ccd_controller/ccd_controller.srcs/src/, 删除原 rtl/ 下的旧副本
2026-08-07 feat(ccd_controller_hardware): 重建 mb_subsystem 块设计适配自制 XC7A35T 控制板 DDR3
    - ccd_controller IP 重新打包导出: 源码注释转 UTF-8, ccd_clk_gen 复位改由
    i_clk_locked(ddr3_init_done) 控制, 不再随 i_rst_n 复位, 保证时钟稳定输出
    - MIG 重配: MT41K256M16XX-125 颗粒、输入时钟 200MHz、ReferenceClock 使用系统
    时钟、读写仲裁改 TDM, 器件列表加入 xc7a35t-fgg484 系列
    - BD: 移除 proc_sys_reset_0(复位改由 MIG sys_rst 直驱), 新增 system_ila_0
    监视 o_slave_fifo_data_wr_en_n, xbar/axi_periph 重建
    - 约束: 移除开发板 GPIO key/led 与 dbg_hub 调试约束, 新增 ccd_clock_ooc.xdc
    OOC 时钟约束, 附 MIG/F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
2026-08-07 feat(ccd_controller_hardware): 帧缓存改固定帧长度+参数变化软复位, 新增 FRAME_WRITTEN 中断/FRAME_NUM 寄存器, MAX_FRAMES 扩至 64
2026-08-07 feat(ccd_controller_software): 采集启动统一为 Ccd_Start(d,n,us), 新增 frame_capacity 查询, 参数变更前自动 Ccd_Stop
2026-08-07 feat(ccd_controller_software): 协议新增 RO exception_flag/exception_cnt 参数供主机查询帧异常状态
2026-08-08 chore: 从 git 追踪移除 *.mmi 构建产物并恢复忽略
2026-08-08 feat(ccd_controller_hardware): 帧异常计数扩为 16bit, ccd_ddr 复位展宽重构, ccd_frame_buf_ddr_ctrl 三域直接异步复位, 重建 ILA 调试核
2026-08-08 feat(ccd_controller_software): 帧异常计数适配 STATUS[15:0] 16bit
2026-08-08 chore: 从 git 追踪移除 _ide/hwspec.checksum 构建产物
2026-08-08 feat(ccd_controller_software): SETPARAM 越界值由 clamp 改为拒绝(ERR 3), exposure_time_us 范围扩至 1:2147483647:1 us
2026-08-08 feat(ccd_controller_hardware): 软复位改由软件控制(CTRL[12]写1自清总复位), 移除参数变化自动软复位, ccd_driver exposure 同步链复位为0防误触发一帧读出, 重建 ccd_controller IP
2026-08-08 feat(ccd_controller_software): CcdController 参数配置封装进 ccd.c(Ccd_Set*/Ccd_SoftReset), protocol 不再直接调用 CcdController
2026-08-08 feat(ccd_controller_hardware): TX done 中断改为 tx_idle 上升沿触发, clk_gen 计数比较改 >=, 重建 ccd_controller IP
2026-08-08 feat(ccd_controller_software): 新增 RESET 命令(停采+软复位), Ccd_SetFreqSel 后自动软复位
    [ccd.c, protocol.c]
2026-08-08 feat(04-driver): 新增 UART 协议回归测试脚本 uart_protocol_test.py
2026-08-13 feat(ccd_controller_hardware): 移除不必要的文件引用
2026-08-13 chore: add design docs
    [ccd-state-machine.json]
2026-08-14 refactor(ccd_controller_hardware): Vivado 工程改为脚本化重建，BD/约束/IP 仓库入库，工程生成物移出版本控制
    - 新增 scripts/bd.tcl：唯一设计源，完整 BD 重建脚本（自包含 MIG 配置）
    - 删除 hardware.tcl：冗余，迁移到 bd.tcl 统一管理
    - 约束迁移至顶层 constraint/（port/clock/debug.xdc）
    - 移除 vivado_proj/、mig_7series_0_ex/、ip/wr_ddr3_fifo_ex/ 的 git 追踪并加入 .gitignore
    - 更新 AGENTS.md（根 + 子项目）以匹配新的脚本化重建工作流
2026-08-14 refactor(ccd_controller_software): Vitis 工程改为仅入库应用源码，平台/BSP/工程文件移出版本控制
    - 移除 mb_subsystem/（平台工程 + BSP + export）、ccd_controller_app_system/、test/、test_system/、perph_test/ 的 git 追踪
    - 移除 ccd_controller_app/ccd_controller_app.prj 工程文件追踪
    - 保留唯一设计源：ccd_controller_app/src/**（应用源码）+ .clangd + tools/gen_ntc_table.py
    - 根 .gitignore 新增 Vitis 生成物规则（mb_subsystem/、*_system/、perph_test/、test/、**/*.prj、**/*.sprj）
    - 更新根 + 子项目 AGENTS.md：主应用为 ccd_controller_app/，Linux Vitis 从 .xsa 重建平台
2026-08-14 fix(.gitignore): 添加对 Vivado 工程目录中特定文件的例外处理
2026-08-14 refactor: 更改创建脚本
2026-08-14 chore: 将 debug.xdc 从仓库中移除
2026-08-14 feat: 修复 tcl 脚本
2026-08-15 fix(.gitignore): 更新 Vitis 生成物的忽略规则，移除不必要的路径
